Synthron/Plantomation/README.md

# Plantomation
Automatic Plant Watering System with ESP32

## V1
Capable of handling 4 channels simultaneously with one pump

## V2
Capable of handling 12 channels simultaneously with two pumps

---
**WORK IN PROGRESS**
