Synthron/Plantomation/V1/doc/titel/titel.tex

\begin{titlepage}

\vspace*{2cm}
\noindent
\titlefont \Titel\par
\epigraph{\Caption}
{\SignateAuthor}
\vspace*{2cm}
\centering{}
\null\vfill
\vspace*{1cm}
\noindent
\hfill
\begin{minipage}{0.4\linewidth}
    \begin{flushright}
        \printauthor
    \end{flushright}
\end{minipage}
%
\begin{minipage}{0.02\linewidth}
    \rule{1pt}{80pt}
\end{minipage}
\titlepagedecoration
\chapterdecoration
\end{titlepage}
