Synthron/Plantomation/V1/doc/tech-note.tex

\documentclass[11pt, a4paper, listof=numbered, captions=tableheading, headinclude, table, xcdraw]{scrreprt}
\usepackage[utf8]{inputenc}
\usepackage{babel}
\usepackage{tikz}
\usepackage{epigraph}
\usepackage{xcolor}
\usepackage{amsmath}
\usepackage{textgreek}
\usepackage[LGRgreek]{mathastext}
\usepackage{array}
\usepackage{color}
\usepackage{graphicx}
\usepackage{float}
\usepackage{helvet}
\usepackage{scrhack}
\usepackage{makecell}
\usepackage{dirtree}
\usepackage{multirow}
\usepackage{listings}
\lstset{language=C,keywordstyle={\bfseries \color{blue}}}
\NewDocumentCommand{\codeword}{v}{%
\texttt{\textcolor{blue}{#1}}%
}
\renewcommand{\familydefault}{\sfdefault}

\RedeclareSectionCommands[toclinefill=\TOCLineLeaderFill]{part,chapter}

\setlength{\emergencystretch}{\hsize}
\tolerance=9999

\usepackage[hidelinks, hypertexnames=false]{hyperref}

\renewcommand\epigraphflush{flushright}
\renewcommand\epigraphsize{\normalsize}
\setlength\epigraphwidth{0.7\textwidth}

\definecolor{titlepagecolor1}{cmyk}{.82,.24,0,.11}
\definecolor{titlepagecolor}{cmyk}{0,.33,.98,.2}

\DeclareFixedFont{\titlefont}{T1}{ppl}{b}{it}{0.5in}

\setlength{\parindent}{0pt}

\usepackage[top=1.5cm,bottom=1cm,right=2cm,left=2cm,includeheadfoot]{geometry}

\newcommand{\Titel}{Documentation\\\vspace{.5mm}Plantomation V1.0}
\newcommand{\Caption}{Automatic Plant Watering System}
\newcommand{\SignateAuthor}{\textit{Made with \LaTeX}}
\newcommand{\Stand}{\textit{Compiled: \today}}

\usepackage[automark]{scrlayer-scrpage}

\input{titel/titel-meta.tex}
\begin{document}
\input{titel/titel.tex}

\KOMAoptions{parskip=half}

\setcounter{tocdepth}{2}
\cohead[I Table Of Contents]{I Table Of Contents}
\pagestyle{scrheadings}
\tableofcontents 	\newpage

\lohead[\today]{\today}
\cohead[Plantomation]{Plantomation}
\rohead[Synthron]{Synthron}
\pagestyle{scrheadings}

\DTsetlength{0.2em}{2em}{0.2em}{0.4pt}{1.6pt}

\input{chapters/00-intro.tex}  	
\input{chapters/01-filesystem.tex}  	
\input{chapters/02-config.tex}
\input{chapters/10-gettingstarted.tex}
\input{chapters/20-troubleshoot.tex}
\input{chapters/30-operation.tex}

\end{document}
