Synthron/Plantomation/V2/3D_files/Valve_Bar.3mf

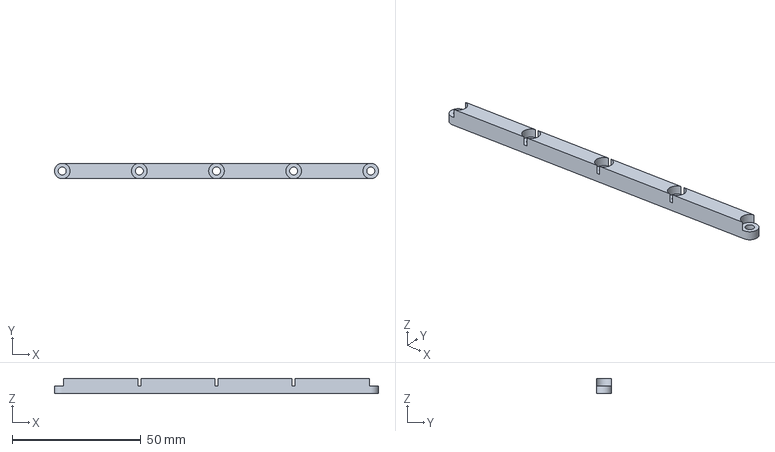
[picture p3: CAD file, 2024-04-07]
V2/3D_files/Valve_Bar.3mf
126.0 x 6.00 x 6.00 mm
