Synthron/Plantomation/V2/Hardware/3d_models/IHLP4040DZ (2.2-100uH).STEP

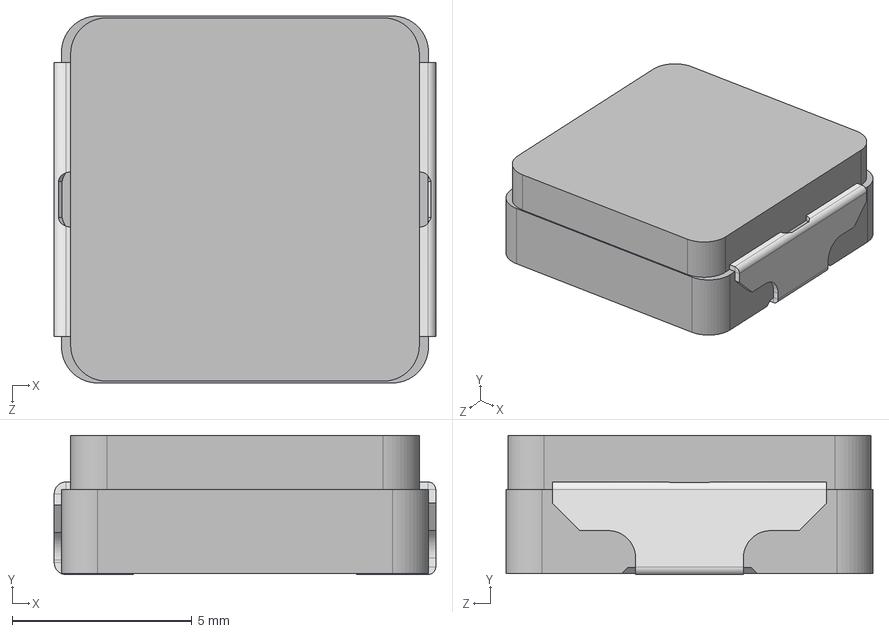
[picture p4: CAD file, 2024-03-05]
V2/Hardware/3d_models/IHLP4040DZ (2.2-100uH).STEP
10.6 x 3.87 x 10.2 mm
