Synthron/Plantomation/V2/3D_files/base.3mf

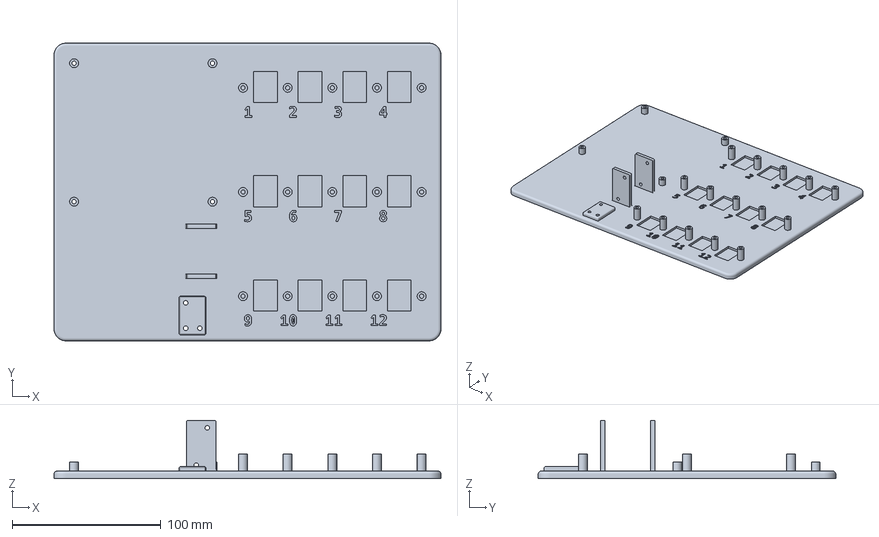
[picture p5: CAD file, 2024-04-07]
V2/3D_files/base.3mf
260.0 x 200.0 x 39.0 mm
