Synthron/Plantomation/V2/Hardware/3d_models/DM3AT-SF-PEJM5--3DModel-STEP-1.STEP

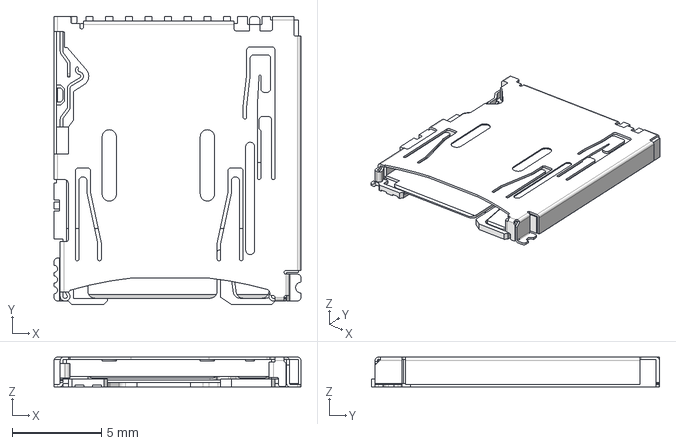
[picture p6: CAD file, 2024-03-05]
V2/Hardware/3d_models/DM3AT-SF-PEJM5--3DModel-STEP-1.STEP
13.8 x 16.2 x 1.68 mm
