Synthron/Plantomation/V2/3D_files/base_v2.FCStd

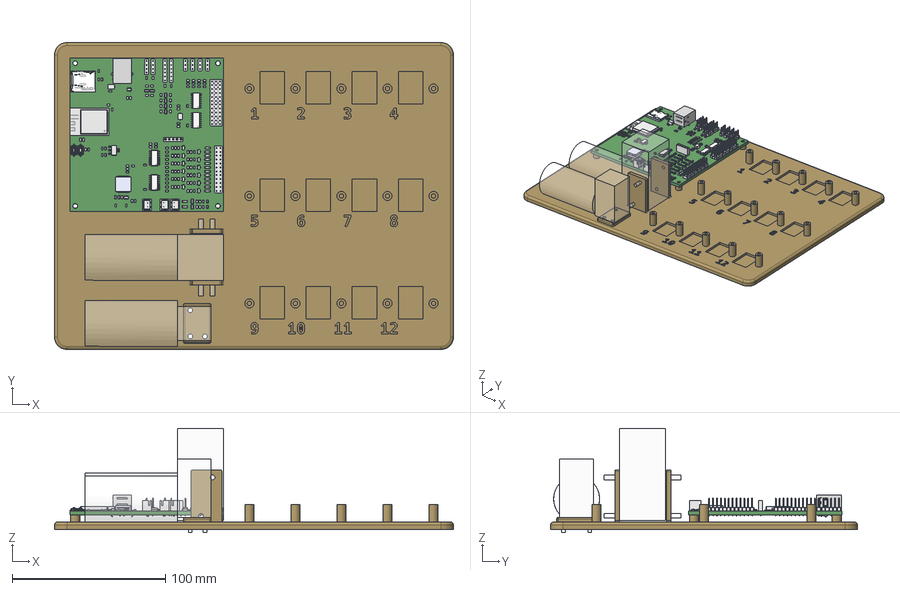
[picture p7: CAD file, 2024-04-07]
V2/3D_files/base_v2.FCStd
260.0 x 200.0 x 68.0 mm
Pcb_db99
Q203_SOT_23_44570731e5b5 x 20
R204_R_0805_2012Metric_d202d1052620 x 75
C110_C_0805_2012Metric_43a1fb40b60a x 32
D211_D_MiniMELF_Standard_09ee5b82a0d6 x 14
D218_LED_0805_2012Metric_5a11dceac025 x 16
SMB-001 x 2
SMB-002 x 2
SMB-003 x 2
J403_PinHeader_1x04_P254mm_Vertical_74da8d033dea x 2
J401_DM3AT-SF-PEJM5_e288499444ba
U102_ESP32-WROOM-32_25d6985203dc
J307_PinHeader_1x03_P254mm_Vertical_c9eca30b1be4 x 4
J406_PinHeader_1x06_P254mm_Vertical_8fe038bee00d x 2
J201_PinHeader_2x12_P254mm_Vertical_0cf915f84885
J301_PinHeader_1x12_P254mm_Vertical_490f5f7cb445 x 3
L101_IHLP4040DZ (2.2-100uH)_65aa9d9f0eec
J204_PinSocket_1x05_P254mm_Vertical_2877e723dfbb
U301_SOIC-16_4.55x10.3mm_P1.27mm_85294fd43e5c x 4
J202_JST_B2B_XH_A_84ebe7f06565 x 3
U105_SOT_223_6202c68c321c
USB-B-S-TH_P
USB-B-S-B-TH_B
USB-B-S-TH_S
U101_SOT_23_6_170c0ff91525 x 2
PTS636Sx25SMTRLFS x 2
PTS636Sx25SMTRLFS001 x 2
PTS636Sx25SMTRLFS002 x 2
PTS636Sx25SMTRLFS003 x 2
PTS636Sx25SMTRLFS004 x 2
NF60
NF25
