Synthron/Plantomation/V2/Hardware/3d_models/USB-B-S-F-B-TH.stp

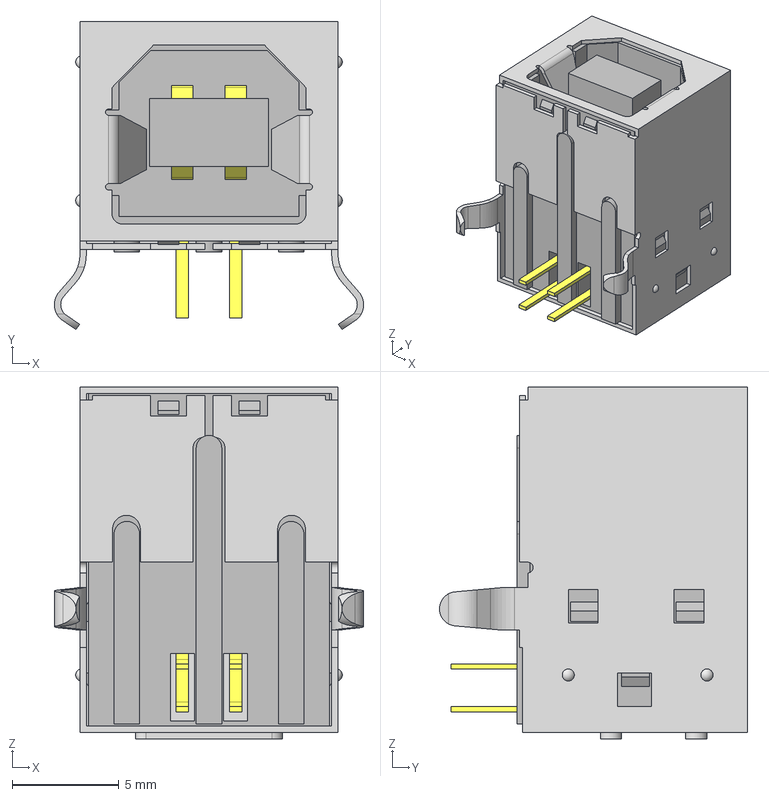
[picture p8: CAD file, 2023-11-27]
V2/Hardware/3d_models/USB-B-S-F-B-TH.stp
14.5 x 14.4 x 16.5 mm
USB-B-S-TH_P
USB-B-S-B-TH_B
USB-B-S-TH_S
