Synthron/Plantomation/V2/3D_files/baseplate-fixbar.3mf

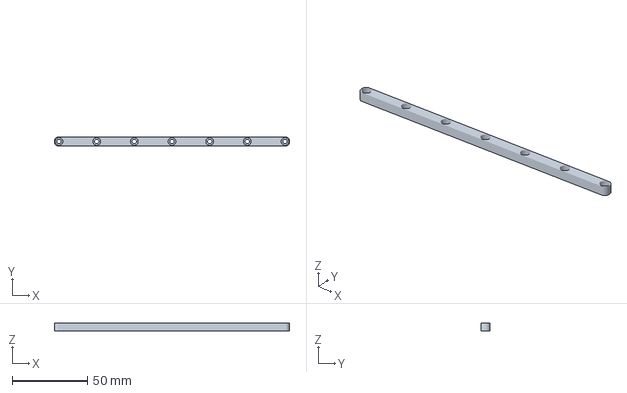
[picture p9: CAD file, 2024-03-17]
V2/3D_files/baseplate-fixbar.3mf
156.0 x 6.00 x 5.00 mm
