Synthron/Plantomation/V2/3D_files/baseplate.FCStd

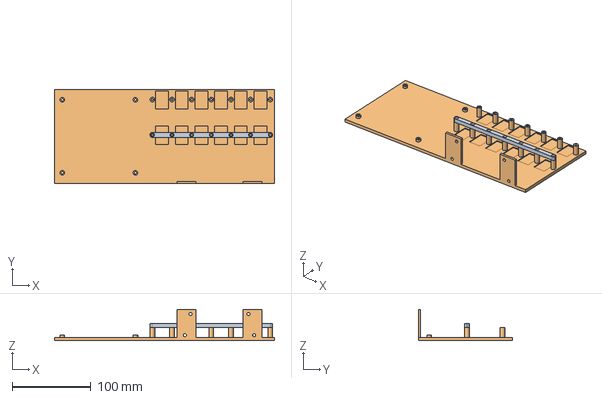
[picture p10: CAD file, 2024-03-17]
V2/3D_files/baseplate.FCStd
280.0 x 120.0 x 40.0 mm
