Synthron/Plantomation/V1/3D Files/base.3mf

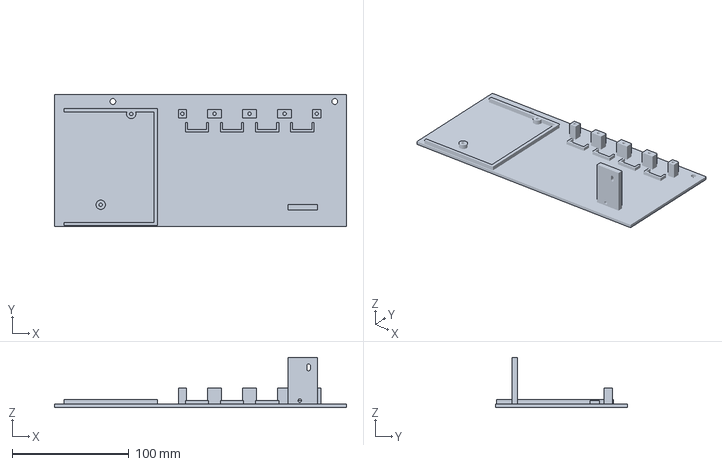
[picture p11: CAD file, 2023-12-03, an earlier design]
V1/3D Files/base.3mf
250.0 x 113.0 x 43.0 mm
