Synthron/Plantomation/V1/carrier_plate.FCStd

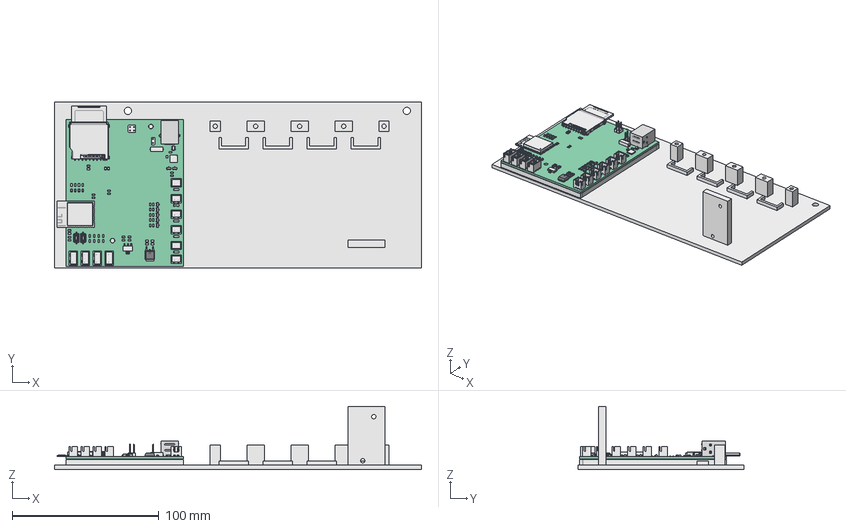
[picture p12: CAD file, 2023-12-03, an earlier design]
V1/carrier_plate.FCStd
250.0 x 113.0 x 43.0 mm
Pcb_6730
R19_R_0805_2012Metric_4a6928e6c3b8 x 27
Q7_SOT_23_91e60cba1a9a x 7
C2_C_0805_2012Metric_00742ca926a0 x 19
U1_ESP32-WROOM-32_6e9d93ef4292
PTS636Sx25SMTRLFS x 2
PTS636Sx25SMTRLFS001 x 2
PTS636Sx25SMTRLFS002 x 2
PTS636Sx25SMTRLFS003 x 2
PTS636Sx25SMTRLFS004 x 2
D4_LED_0805_2012Metric_402ffccf9469 x 4
932d09b3-9c39-11ed-93f0-dde97e994e83_part
932d09b4-9c39-11ed-93f0-dde97e994e83_part
932d09b5-9c39-11ed-93f0-dde97e994e83_part
932d09b5-9c39-11ed-93f0-dde97e994e83_part001
932d09b5-9c39-11ed-93f0-dde97e994e83_part002
D6_D_MiniMELF_Standard_5b1763afe809 x 5
J6_JST_B3B_XH_A_3265b5583f52 x 4
U4_SOT_223_8c25a17023d9
J9_JST_B2B_XH_A_89ff38e0742e x 6
SD Card
SD Card001
U5_QFN-28-1EP_5x5mm_Pitch0.5mm_6fd3eef4e2dd
U2_SOT_23_6_705da7459335
SMB-002
SMB-003
SMB-004
J13_PinHeader_2x02_P254mm_Vertical_e2c9f7a34c26
JP1_PinHeader_1x02_P254mm_Vertical_8e198357df73
USB-B-S-TH_P
USB-B-S-B-TH_B
USB-B-S-TH_S
