Synthron/Plantomation/V1/Hardware/3d_models/fk_244_13_d_pak.stp

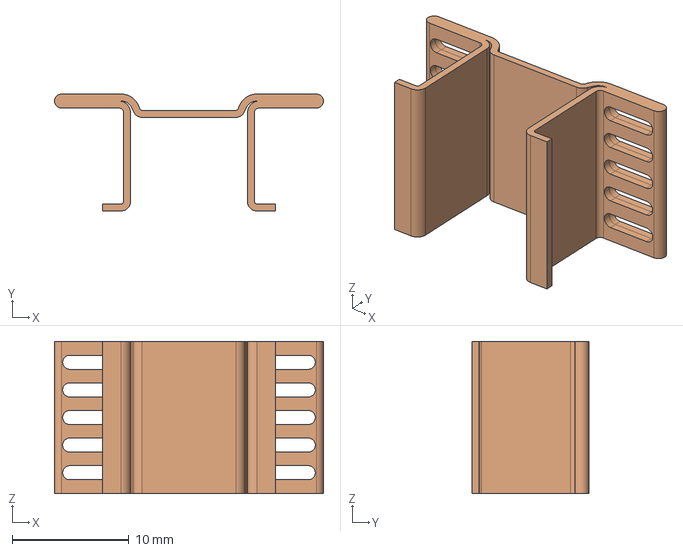
[picture p13: CAD file, 2023-11-27, an earlier design]
V1/Hardware/3d_models/fk_244_13_d_pak.stp
23.0 x 10.0 x 13.0 mm
