Synthron/Plantomation/V1/3D Files/fixer.3mf

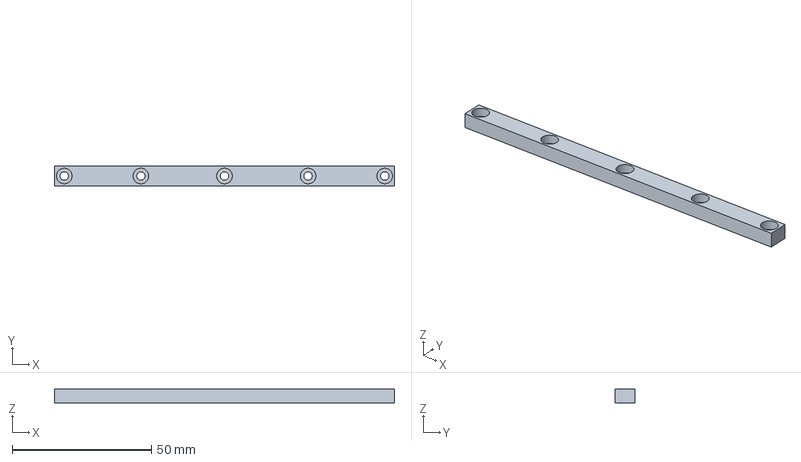
[picture p14: CAD file, 2023-11-30, an earlier design]
V1/3D Files/fixer.3mf
122.0 x 7.00 x 5.00 mm
