Synthron/Plantomation/V1/3D Files/hose_fix.3mf

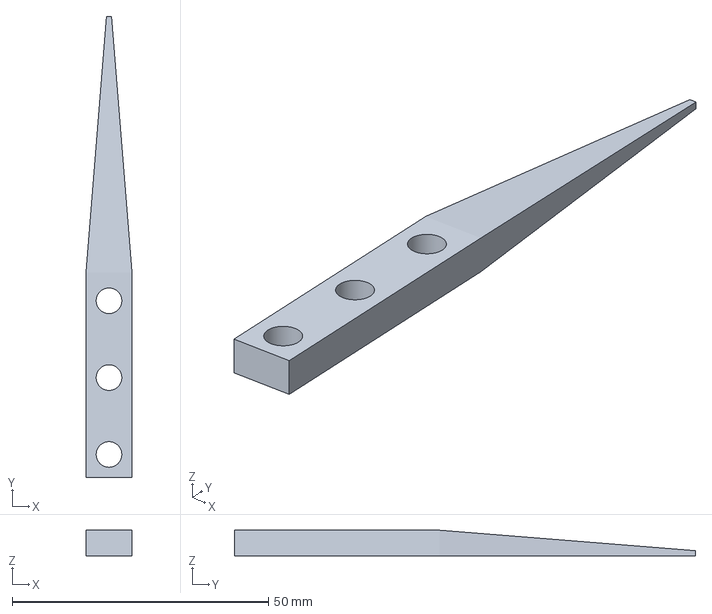
[picture p15: CAD file, 2023-11-30, an earlier design]
V1/3D Files/hose_fix.3mf
9.00 x 90.0 x 5.00 mm
