Synthron/Plantomation/V1/Hardware/3d_models/SD Card.STEP

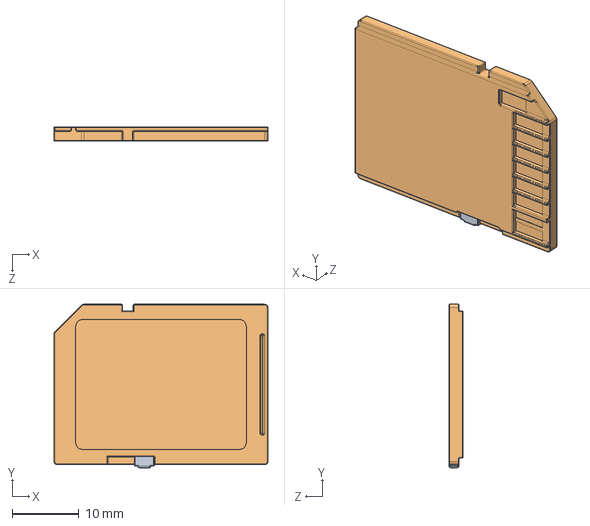
[picture p16: CAD file, 2023-11-26, an earlier design]
V1/Hardware/3d_models/SD Card.STEP
32.0 x 24.4 x 2.15 mm
