Synthron/Plantomation/V1/Hardware/3d_models/GSD090012SEU.stp

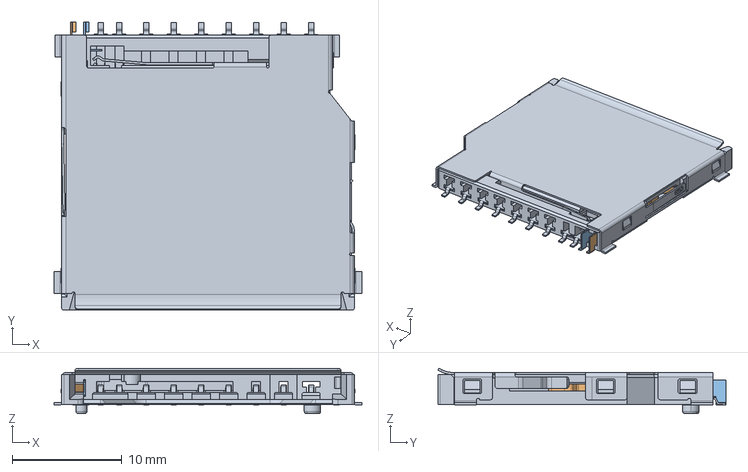
[picture p17: CAD file, 2023-11-27, an earlier design]
V1/Hardware/3d_models/GSD090012SEU.stp
28.0 x 26.2 x 4.13 mm
