Synthron/Plantomation/(list of files, cad)

Other CAD files:
V1/3D Files/carrier_plate.FCStd
V2/3D_files/baseplate.3mf
