Synthron/Plantomation/V1/Hardware/Plantomation.pdf

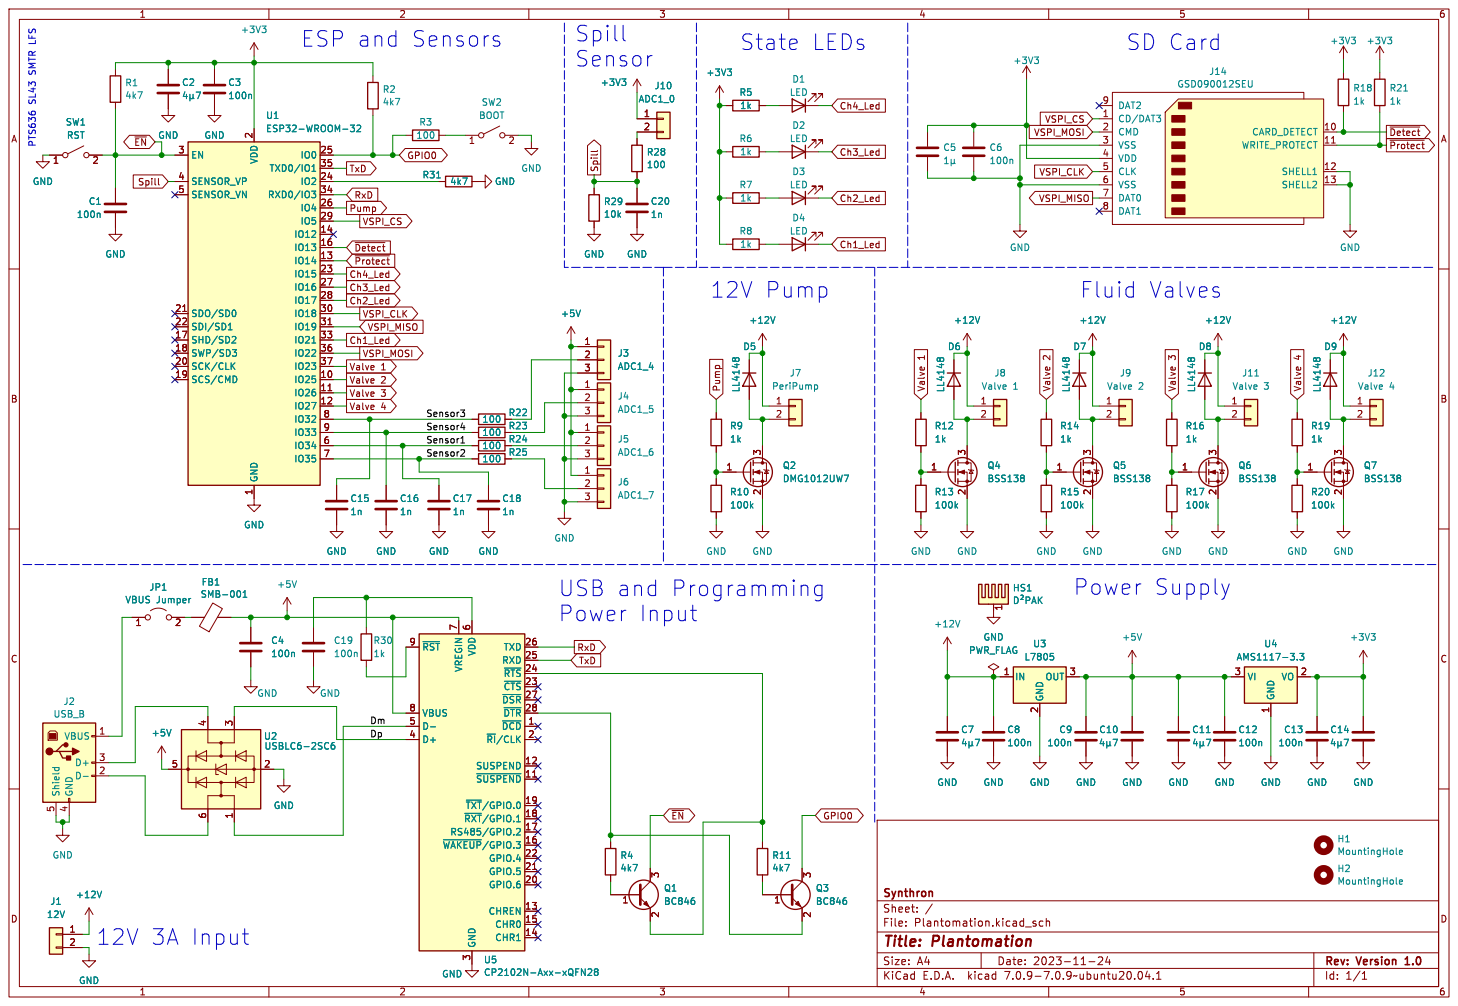
[picture p18: page 1]

Power Supply PTS636 SL43 SMTR LFS

2 SCK/CLK 20 SDO/SD0 21 SDI/SD1 22
