Synthron/Plantomation/V2/Hardware/Plantomation_V2.kicad_pcb

## KiCad design V2/Hardware/Plantomation_V2.kicad_pcb (2024-03-17)

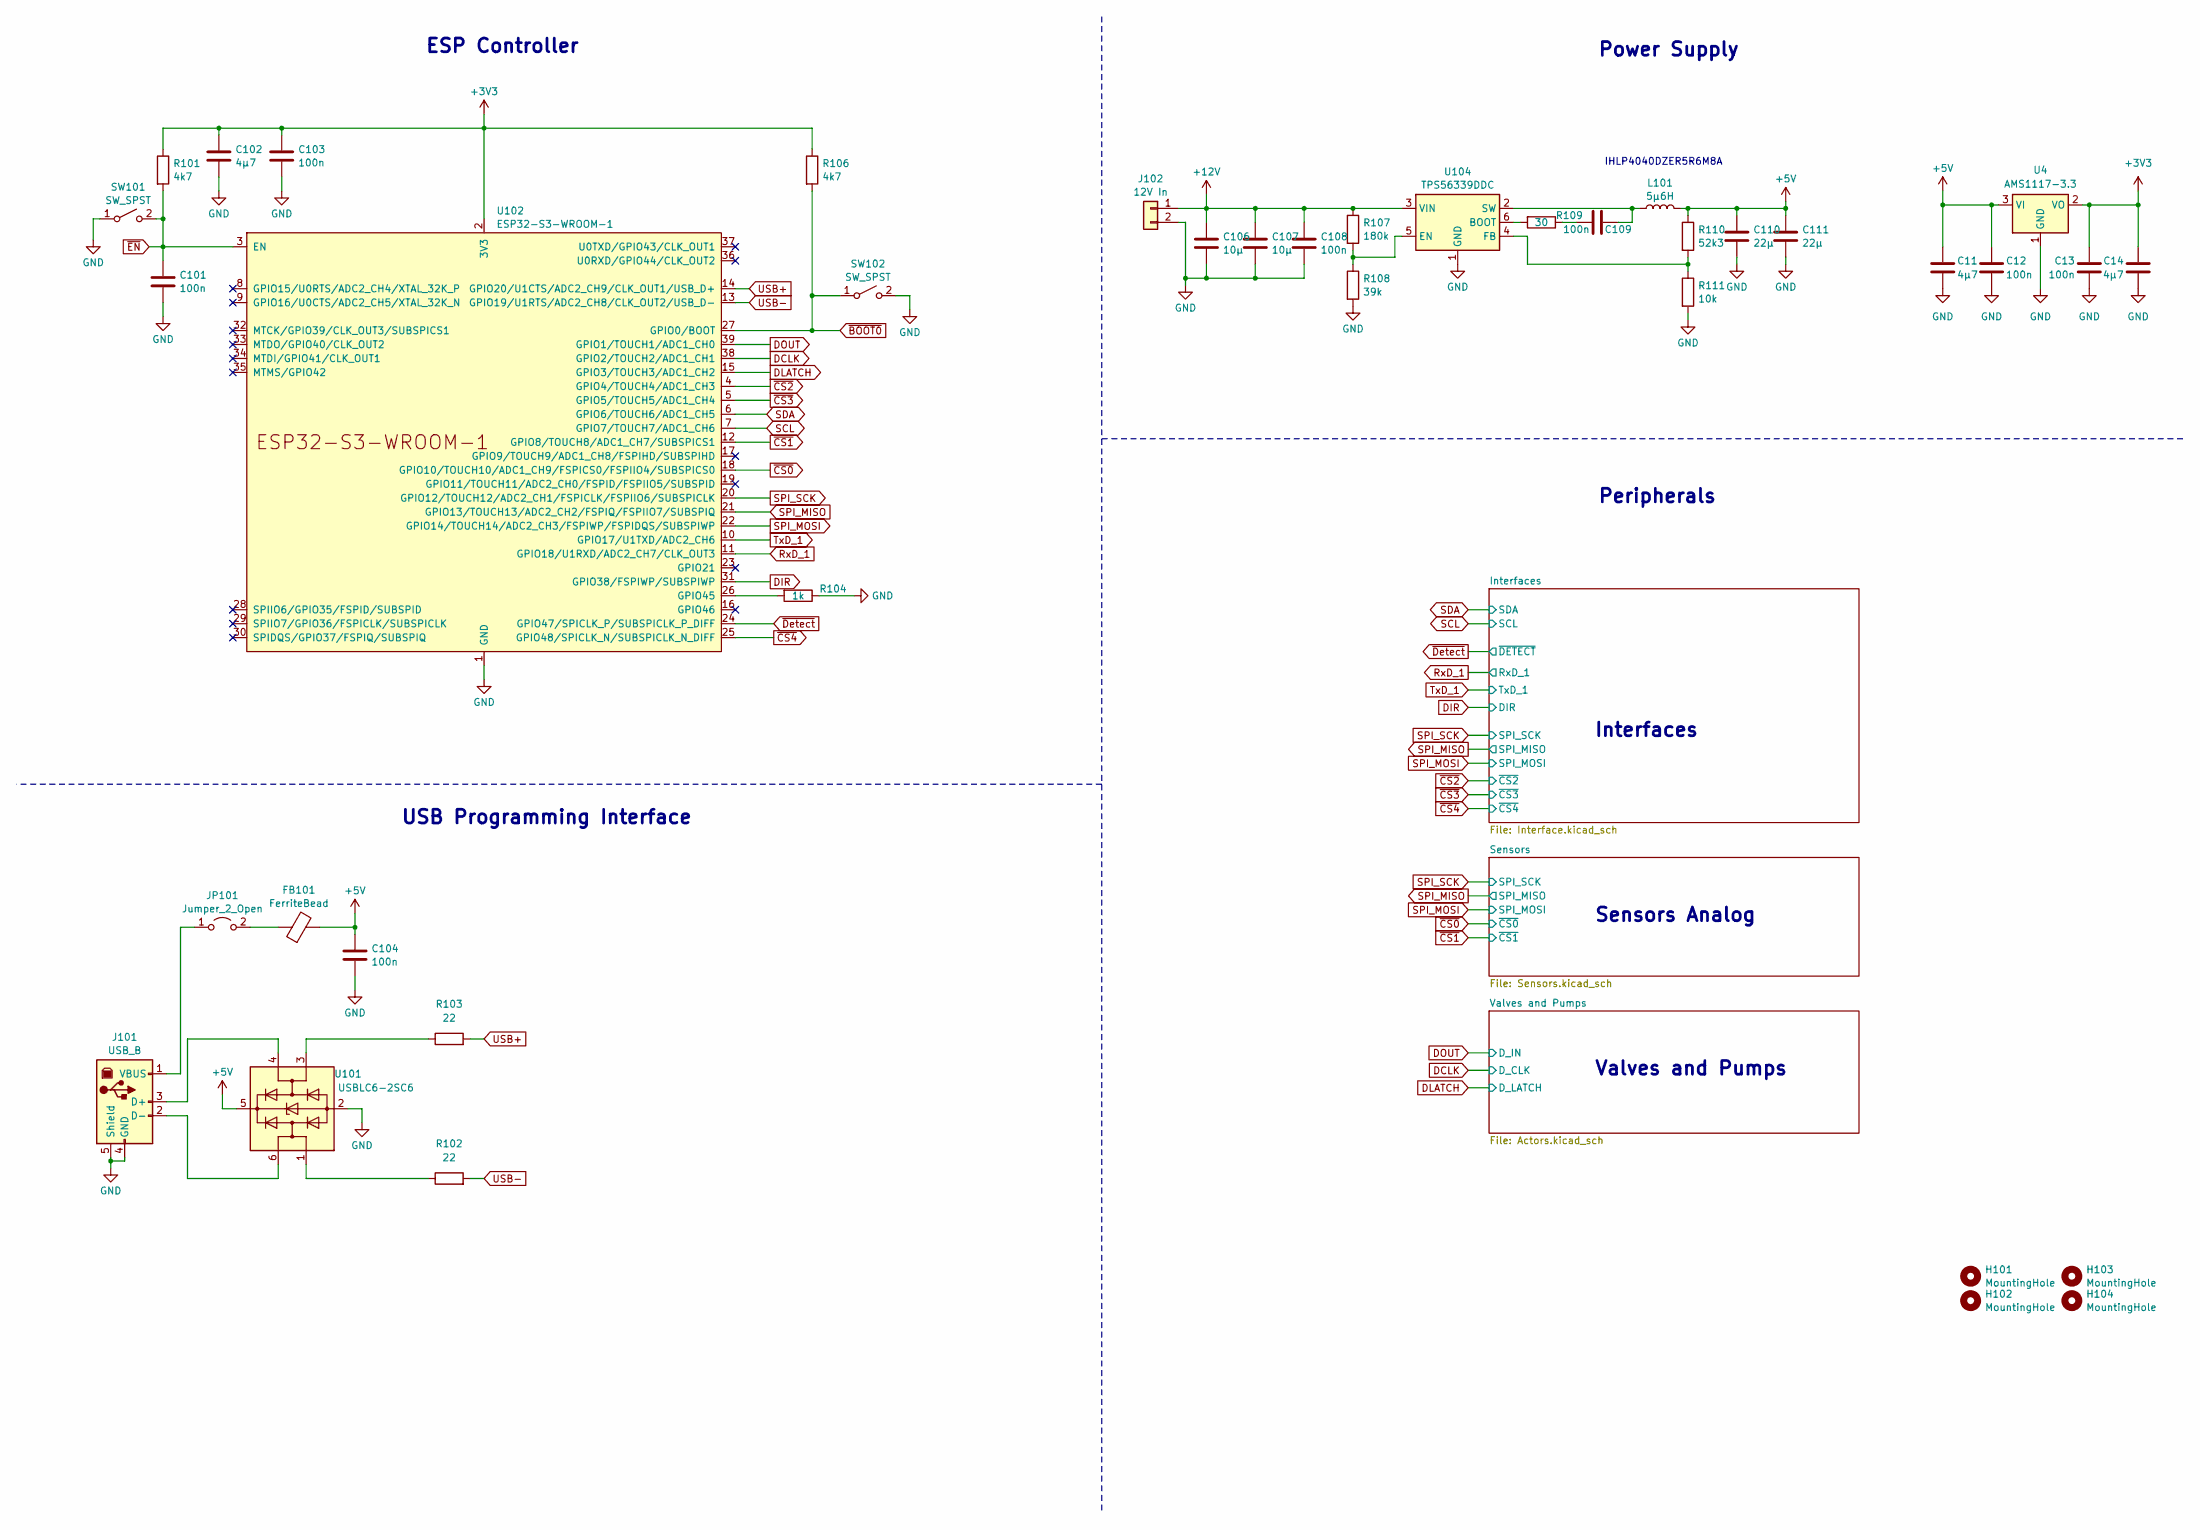
[picture p19: schematic Plantomation_V2.kicad_sch, Plantomation V2]

Parts:
C11, C14, C102: 4µ7; C_0805_2012Metric
C12, C13, C101, C103, C104, C108, C109: 100n; C_0805_2012Metric
C106, C107: 10µ; C_0805_2012Metric
C110, C111: 22µ; C_0805_2012Metric
FB101: FerriteBead; SMB-001
H101, H102, H103, H104: MountingHole; MountingHole_3.2mm_M3
J101: USB_B; USB_B_Lumberg_2411_02_Horizontal
J102: 12V In; JST_XH_B2B-XH-A_1x02_P2.50mm_Vertical
JP101: Jumper_2_Open; SolderJumper-2_P1.3mm_Open_TrianglePad1.0x1.5mm
L101: 5µ6H; L_Vishay_IHLP-4040
R101, R106: 4k7; R_0805_2012Metric
R102, R103: 22; R_0805_2012Metric
R104: 1k; R_0805_2012Metric
R107: 180k; R_0805_2012Metric
R108: 39k; R_0805_2012Metric
R109: 30; R_0805_2012Metric
R110: 52k3; R_0805_2012Metric
R111: 10k; R_0805_2012Metric
SW101, SW102: SW_SPST; SW_Tactile_SPST_NO_Straight_CK_PTS636Sx25SMTRLFS
U4: AMS1117-3.3; SOT-223-3_TabPin2
U101: USBLC6-2SC6; SOT-23-6
U102: ESP32-S3-WROOM-1
U104: TPS56339DDC; SOT-23-6

Connections:
+3V3: C102.1, C103.1, R101.1, R106.1, U102.2 (3V3); also elsewhere on the board
+5V: C104.1, C110.1, C111.1, FB101.2, L101.2, R110.1, U101.5 (VBUS); also elsewhere on the board
+12V: C106.1, C107.1, C108.1, J102.1, R107.1, U104.3 (VIN); also elsewhere on the board
DCLK: U102.38 (GPIO2/TOUCH2/ADC1_CH1); also elsewhere on the board
DIR: U102.31 (GPIO38/FSPIWP/SUBSPIWP)
DLATCH: U102.15 (GPIO3/TOUCH3/ADC1_CH2); also elsewhere on the board
DOUT: U102.39 (GPIO1/TOUCH1/ADC1_CH0); also elsewhere on the board
GND: C101.2, C102.2, C103.2, C104.2, C106.2, C107.2, C108.2, C110.2, C111.2, J101.4 (GND), J101.5 (Shield), J102.2, R104.1, R108.2, R111.2, SW101.1 (A), SW102.2 (B), U101.2 (GND), U102.1 (GND), U102.40 (GND), U102.41 (GND), U104.1 (GND); also elsewhere on the board
unnamed: C109.1, R109.1
unnamed: J101.3 (D+), U101.4 (I/O2)
unnamed: J101.2 (D-), U101.6 (I/O1)
unnamed: J101.1 (VBUS), JP101.1 (A)
unnamed: FB101.1, JP101.2 (B)
unnamed: R102.1, U101.1 (I/O1)
unnamed: R103.1, U101.3 (I/O2)
unnamed: R104.2, U102.26 (GPIO45)
unnamed: R109.2, U104.6 (BOOT)
unnamed: R107.2, R108.1, U104.5 (EN)
unnamed: R110.2, R111.1, U104.4 (FB)
unnamed: C109.2, L101.1, U104.2 (SW)
RxD_1: U102.11 (GPIO18/U1RXD/ADC2_CH7/CLK_OUT3)
SCL: U102.7 (GPIO7/TOUCH7/ADC1_CH6); also elsewhere on the board
SDA: U102.6 (GPIO6/TOUCH6/ADC1_CH5); also elsewhere on the board
SPI_MISO: U102.21 (GPIO13/TOUCH13/ADC2_CH2/FSPIQ/FSPIIO7/S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); also elsewhere on the board
SPI_MOSI: U102.22 (GPIO14/TOUCH14/ADC2_CH3/FSPIWP/FSPIDQS/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); also elsewhere on the board
SPI_SCK: U102.20 (GPIO12/TOUCH12/ADC2_CH1/FSPICLK/FSPIIO6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); also elsewhere on the board
TxD_1: U102.10 (GPIO17/U1TXD/ADC2_CH6)
USB+: R103.2, U102.14 (GPIO20/U1CTS/ADC2_CH9/CLK_OUT1/USB_D+)
USB-: R102.2, U102.13 (GPIO19/U1RTS/ADC2_CH8/CLK_OUT2/USB_D-)
~BOOT0: R106.2, SW102.1 (A), U102.27 (GPIO0/BOOT)
~CS0: U102.18 (GPIO10/TOUCH10/ADC1_CH9/FSPICS0/FSPIIO4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); also elsewhere on the board
~CS1: U102.12 (GPIO8/TOUCH8/ADC1_CH7/SUBSPICS1); also elsewhere on the board
~CS2: U102.4 (GPIO4/TOUCH4/ADC1_CH3); also elsewhere on the board
~CS3: U102.5 (GPIO5/TOUCH5/ADC1_CH4); also elsewhere on the board
~CS4: U102.25 (GPIO48/SPICLK_N/SUBSPICLK_N_DIFF); also elsewhere on the board
~Detect: U102.24 (GPIO47/SPICLK_P/SUBSPICLK_P_DIFF); also elsewhere on the board
~EN: C101.1, R101.2, SW101.2 (B), U102.3 (EN)

Notes on the sheet:
Valves and Pumps
IHLP4040DZER5R6M8A
Interfaces
Sensors Analog
Peripherals
Power Supply
ESP Controller
USB Programming Interface

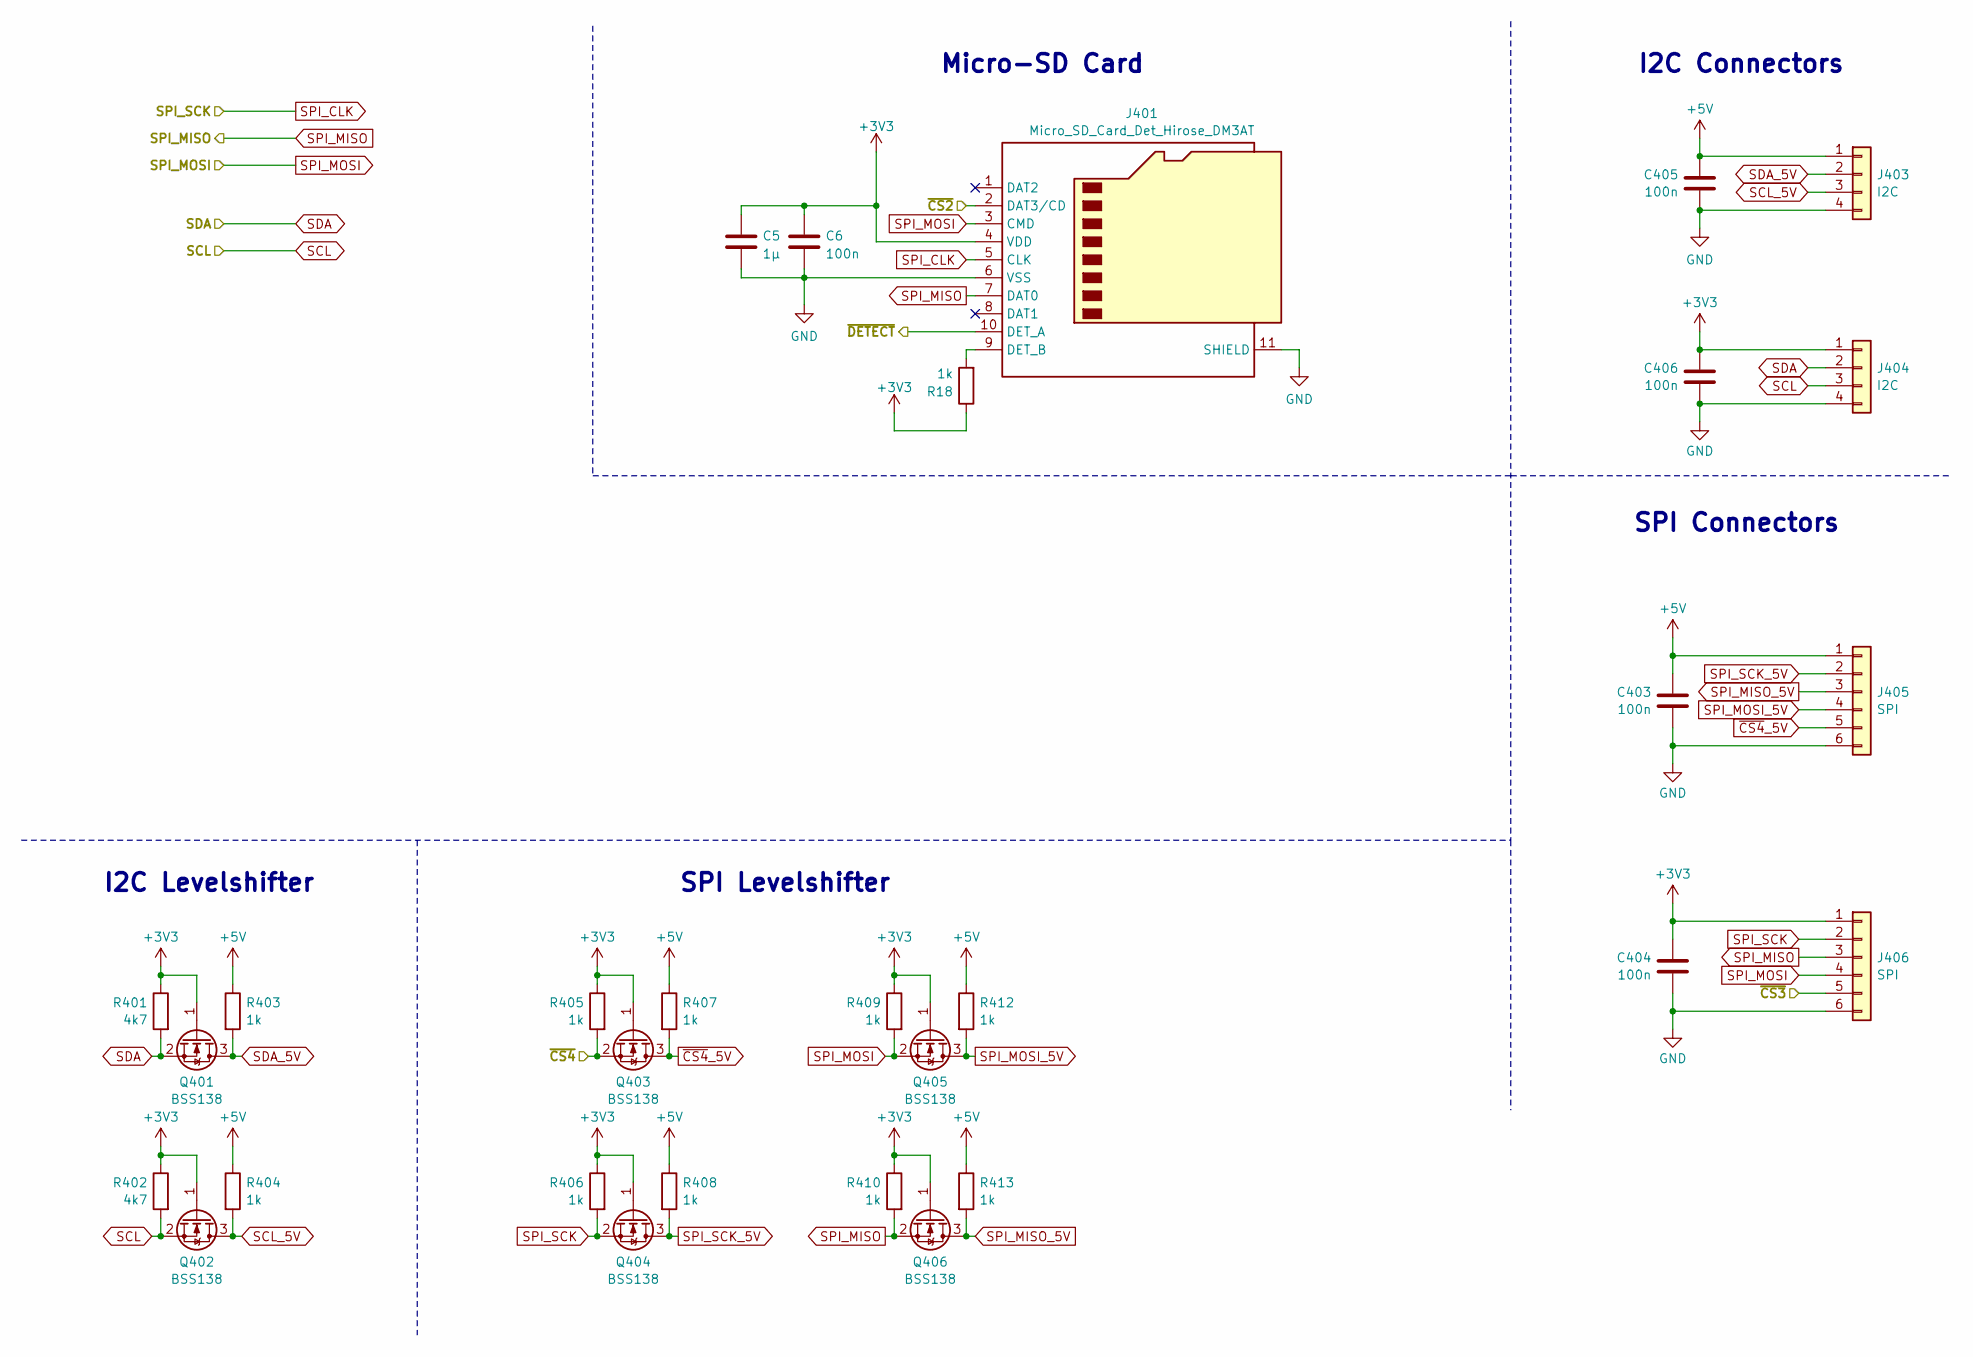
[picture p20: schematic Interface.kicad_sch]

Parts:
C5: 1µ; C_0805_2012Metric
C6, C403, C404, C405, C406: 100n; C_0805_2012Metric
J401: Micro_SD_Card_Det_Hirose_DM3AT; microSD_HC_Hirose_DM3AT-SF-PEJM5
J403, J404: I2C; PinHeader_1x04_P2.54mm_Vertical
J405, J406: SPI; PinHeader_1x06_P2.54mm_Vertical
Q401, Q402, Q403, Q404, Q405, Q406: BSS138; SOT-23
R18, R403, R404, R405, R406, R407, R408, R409, R410, R412, R413: 1k; R_0805_2012Metric
R401, R402: 4k7; R_0805_2012Metric

Connections:
+3V3: C404.1, C406.1, J401.4 (VDD), J404.1, J406.1, Q401.1 (G), Q402.1 (G), Q403.1 (G), Q404.1 (G), Q405.1 (G), Q406.1 (G), R401.1, R402.1, R405.1, R406.1, R409.1, R410.1; also elsewhere on the board
+5V: C403.1, C405.1, J403.1, J405.1, R403.1, R404.1, R407.1, R408.1, R412.1, R413.1; also elsewhere on the board
GND: C403.2, C404.2, C405.2, C406.2, J401.6 (VSS), J401.11 (SHIELD), J403.4, J404.4, J405.6, J406.6; also elsewhere on the board
unnamed 51: J401.9 (DET_B); also elsewhere on the board
SCL: J404.3, Q402.2 (S), R402.2; also elsewhere on the board
SCL_5V: J403.3, Q402.3 (D), R404.2
SDA: J404.2, Q401.2 (S), R401.2; also elsewhere on the board
SDA_5V: J403.2, Q401.3 (D), R403.2
SPI_MISO: J401.7 (DAT0), J406.3, Q406.2 (S), R410.2; also elsewhere on the board
SPI_MISO_5V: J405.3, Q406.3 (D), R413.2
SPI_MOSI: J401.3 (CMD), J406.4, Q405.2 (S), R409.2; also elsewhere on the board
SPI_MOSI_5V: J405.4, Q405.3 (D), R412.2
SPI_SCK: J401.5 (CLK), J406.2, Q404.2 (S), R406.2; also elsewhere on the board
SPI_SCK_5V: J405.2, Q404.3 (D), R408.2
~CS2: J401.2 (DAT3/CD); also elsewhere on the board
~CS3: J406.5; also elsewhere on the board
~CS4: Q403.2 (S), R405.2; also elsewhere on the board
~CS4_5V: J405.5, Q403.3 (D), R407.2
~Detect: J401.10 (DET_A); also elsewhere on the board

Notes on the sheet:
I2C Connectors
SPI Levelshifter
Micro-SD Card
SPI Connectors
I2C Levelshifter

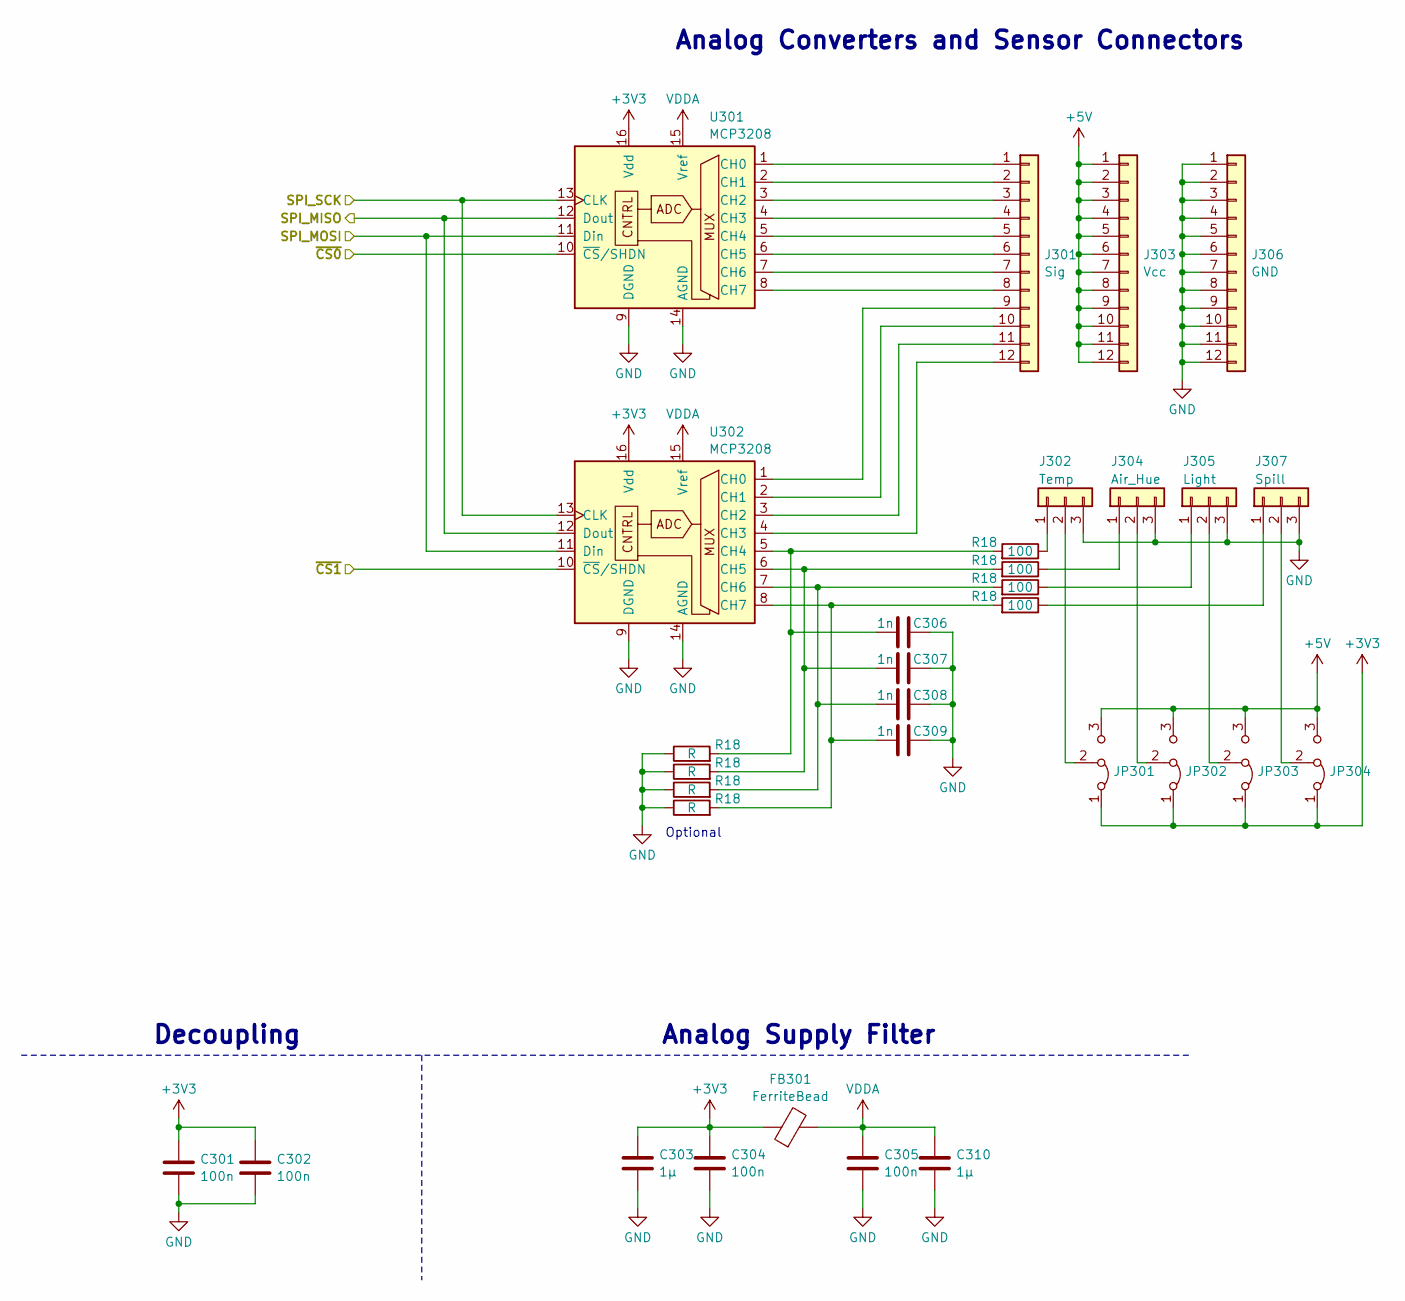
[picture p21: schematic Sensors.kicad_sch]

Parts:
C301, C302, C304, C305: 100n; C_0805_2012Metric
C303, C310: 1µ; C_0805_2012Metric
C306, C307, C308, C309: 1n; C_0805_2012Metric
FB301: FerriteBead; SMB-001
J301: Sig; PinHeader_1x12_P2.54mm_Vertical
J302: Temp; PinHeader_1x03_P2.54mm_Vertical
J303: Vcc; PinHeader_1x12_P2.54mm_Vertical
J304: Air_Hue; PinHeader_1x03_P2.54mm_Vertical
J305: Light; PinHeader_1x03_P2.54mm_Vertical
J306: GND; PinHeader_1x12_P2.54mm_Vertical
J307: Spill; PinHeader_1x03_P2.54mm_Vertical
JP301, JP302, JP303, JP304: Jumper_3_Bridged12; SolderJumper-3_P1.3mm_Open_Pad1.0x1.5mm
R18: R; R_0805_2012Metric
U301, U302: MCP3208; SOIC-16_4.55x10.3mm_P1.27mm

Connections:
+3V3: C301.1, C302.1, C303.1, C304.1, FB301.1, JP301.1 (A), JP302.1 (A), JP303.1 (A), JP304.1 (A), U301.16 (Vdd), U302.16 (Vdd); also elsewhere on the board
+5V: J303.1, J303.2, J303.3, J303.4, J303.5, J303.6, J303.7, J303.8, J303.9, J303.10, J303.11, J303.12, JP301.3 (B), JP302.3 (B), JP303.3 (B), JP304.3 (B); also elsewhere on the board
GND: C301.2, C302.2, C303.2, C304.2, C305.2, C306.2, C307.2, C308.2, C309.2, C310.2, J302.3, J304.3, J305.3, J306.1, J306.2, J306.3, J306.4, J306.5, J306.6, J306.7, J306.8, J306.9, J306.10, J306.11, J306.12, J307.3, U301.9 (DGND), U301.14 (AGND), U302.9 (DGND), U302.14 (AGND); also elsewhere on the board
unnamed: J301.1, U301.1 (CH0)
unnamed: J301.2, U301.2 (CH1)
unnamed: J301.3, U301.3 (CH2)
unnamed: J301.4, U301.4 (CH3)
unnamed: J301.5, U301.5 (CH4)
unnamed: J301.6, U301.6 (CH5)
unnamed: J301.7, U301.7 (CH6)
unnamed: J301.8, U301.8 (CH7)
unnamed: J301.9, U302.1 (CH0)
unnamed: J301.10, U302.2 (CH1)
unnamed: J301.11, U302.3 (CH2)
unnamed: J301.12, U302.4 (CH3)
unnamed 43: J302.1; also elsewhere on the board
unnamed: J302.2, JP301.2 (C)
unnamed 45: J304.1; also elsewhere on the board
unnamed: J304.2, JP302.2 (C)
unnamed 47: J305.1; also elsewhere on the board
unnamed: J305.2, JP303.2 (C)
unnamed 49: J307.1; also elsewhere on the board
unnamed: J307.2, JP304.2 (C)
unnamed 75: C306.1, U302.5 (CH4); also elsewhere on the board
unnamed 76: C307.1, U302.6 (CH5); also elsewhere on the board
unnamed 77: C308.1, U302.7 (CH6); also elsewhere on the board
unnamed 78: C309.1, U302.8 (CH7); also elsewhere on the board
SPI_MISO: U301.12 (Dout), U302.12 (Dout); also elsewhere on the board
SPI_MOSI: U301.11 (Din), U302.11 (Din); also elsewhere on the board
SPI_SCK: U301.13 (CLK), U302.13 (CLK); also elsewhere on the board
VDDA: C305.1, C310.1, FB301.2, U301.15 (Vref), U302.15 (Vref)
~CS0: U301.10 (~CS/SHDN); also elsewhere on the board
~CS1: U302.10 (~CS/SHDN); also elsewhere on the board

Notes on the sheet:
Analog Converters and Sensor Connectors
Analog Supply Filter
Decoupling
Optional

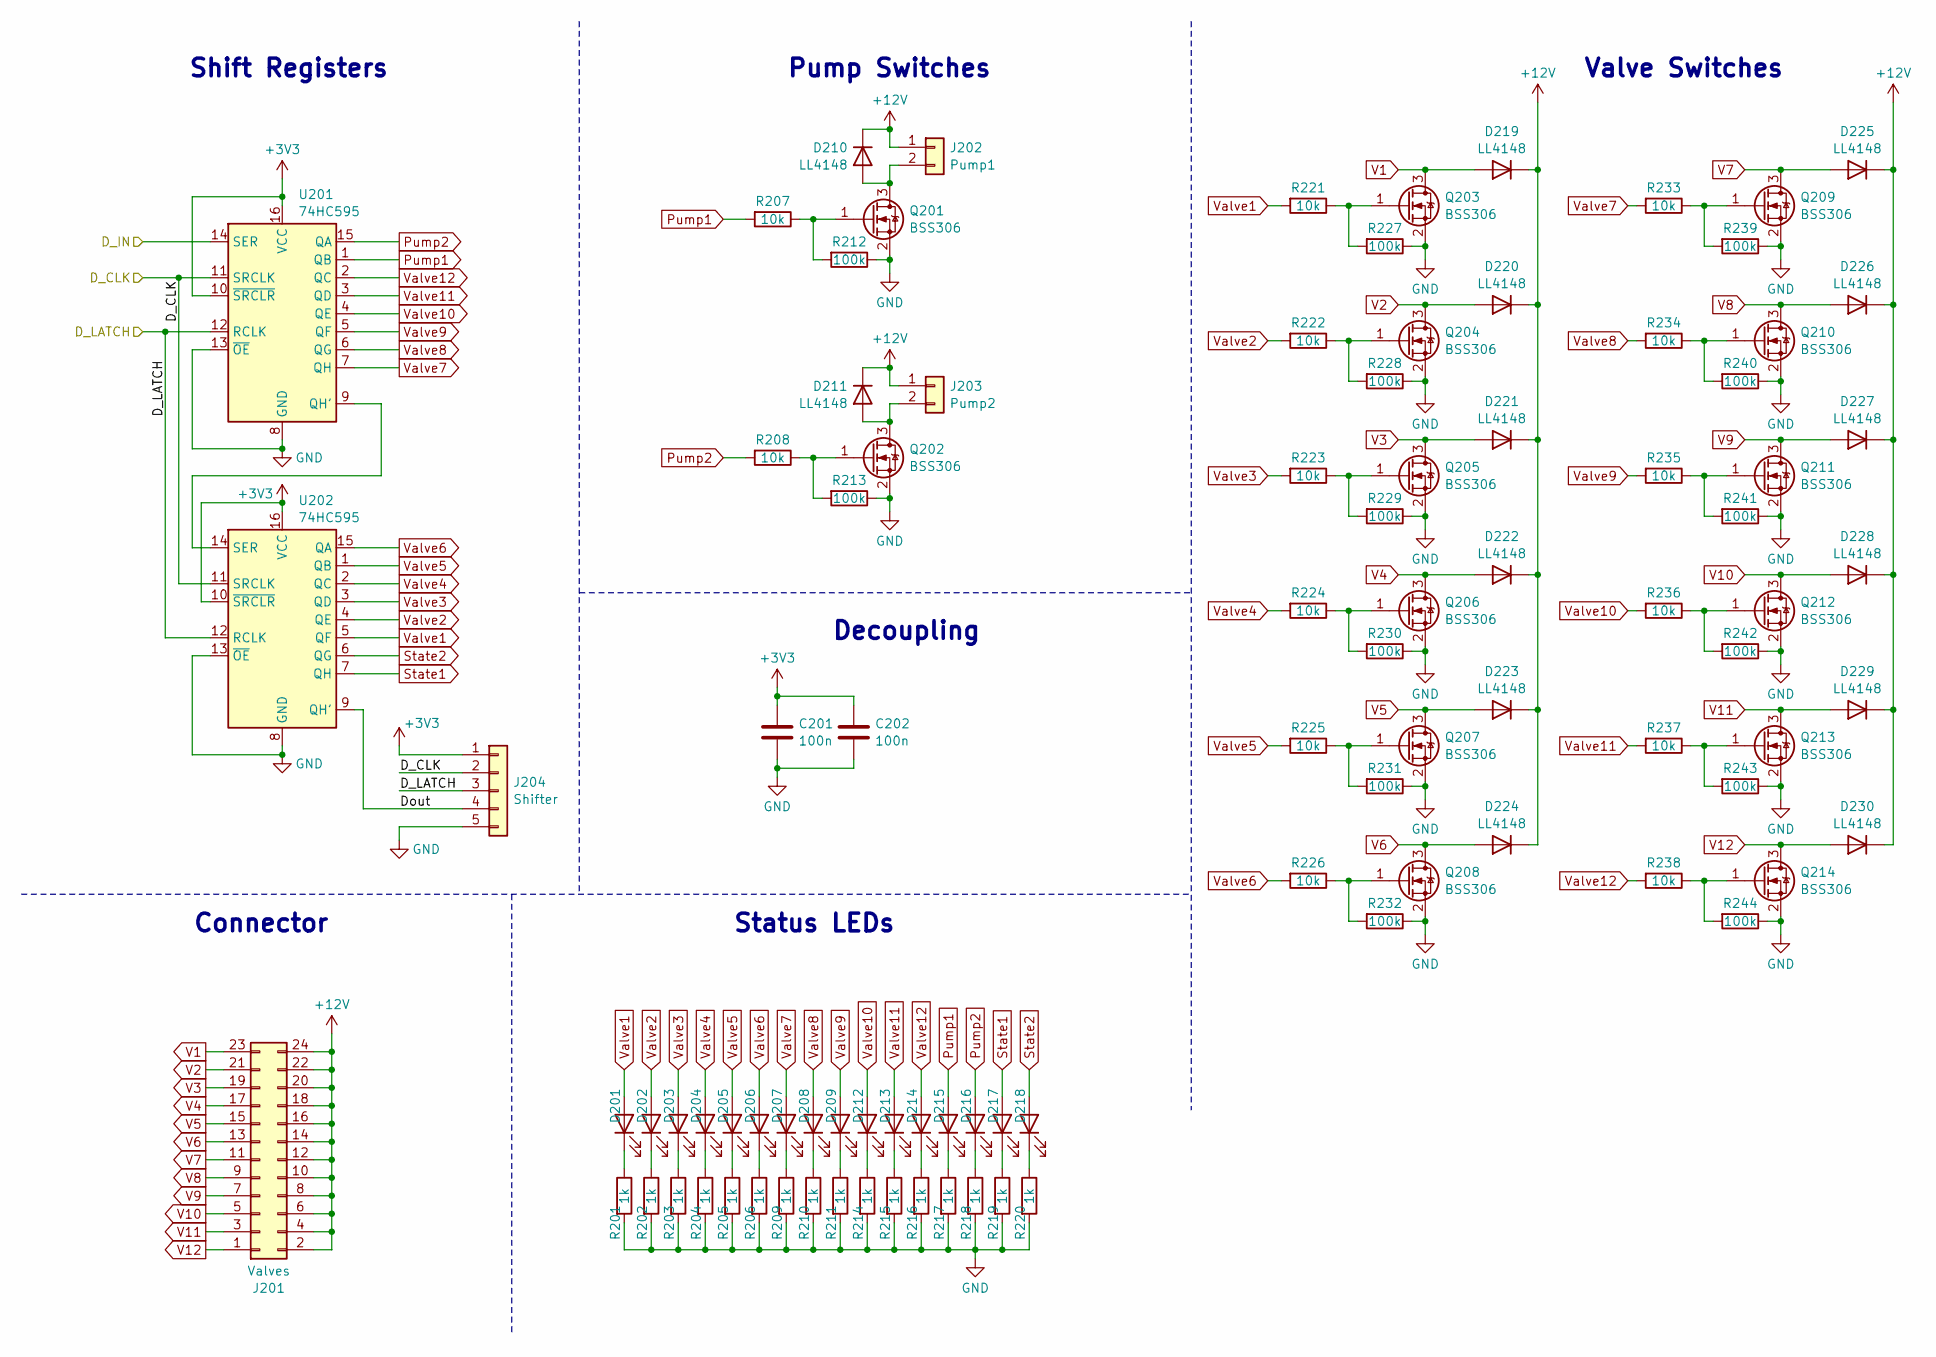
[picture p22: schematic Actors.kicad_sch]

Parts:
C201, C202: 100n; C_0805_2012Metric
D201, D202, D203, D204, D205, D206, D207, D208, D209, D212, D213, D214, D215, D216, D217, D218: LED; LED_0805_2012Metric
D210, D211, D219, D220, D221, D222, D223, D224, D225, D226, D227, D228, D229, D230: LL4148; D_MiniMELF
J201: Valves; PinHeader_2x12_P2.54mm_Vertical
J202: Pump1; JST_XH_B2B-XH-A_1x02_P2.50mm_Vertical
J203: Pump2; JST_XH_B2B-XH-A_1x02_P2.50mm_Vertical
J204: Shifter; PinSocket_1x05_P2.54mm_Vertical
Q201, Q202, Q203, Q204, Q205, Q206, Q207, Q208, Q209, Q210, Q211, Q212, Q213, Q214: BSS306; SOT-23-3
R201, R202, R203, R204, R205, R206, R209, R210, R211, R214, R215, R216, R217, R218, R219, R220: 1k; R_0805_2012Metric
R207, R208, R221, R222, R223, R224, R225, R226, R233, R234, R235, R236, R237, R238: 10k; R_0805_2012Metric
R212, R213, R227, R228, R229, R230, R231, R232, R239, R240, R241, R242, R243, R244: 100k; R_0805_2012Metric
U201, U202: 74HC595; SOIC-16_4.55x10.3mm_P1.27mm

Connections:
+3V3: C201.1, C202.1, J204.1, U201.10 (~SRCLR), U201.16 (VCC), U202.10 (~SRCLR), U202.16 (VCC); also elsewhere on the board
+12V: D210.1 (K), D211.1 (K), D219.1 (K), D220.1 (K), D221.1 (K), D222.1 (K), D223.1 (K), D224.1 (K), D225.1 (K), D226.1 (K), D227.1 (K), D228.1 (K), D229.1 (K), D230.1 (K), J201.2, J201.4, J201.6, J201.8, J201.10, J201.12, J201.14, J201.16, J201.18, J201.20, J201.22, J201.24, J202.1, J203.1; also elsewhere on the board
/Valves and Pumps/Dout: J204.4, U202.9 (QH')
DCLK: J204.2, U201.11 (SRCLK), U202.11 (SRCLK); also elsewhere on the board
DLATCH: J204.3, U201.12 (RCLK), U202.12 (RCLK); also elsewhere on the board
DOUT: U201.14 (SER); also elsewhere on the board
GND: C201.2, C202.2, J204.5, Q201.2 (S), Q202.2 (S), Q203.2 (S), Q204.2 (S), Q205.2 (S), Q206.2 (S), Q207.2 (S), Q208.2 (S), Q209.2 (S), Q210.2 (S), Q211.2 (S), Q212.2 (S), Q213.2 (S), Q214.2 (S), R201.2, R202.2, R203.2, R204.2, R205.2, R206.2, R209.2, R210.2, R211.2, R212.1, R213.1, R214.2, R215.2, R216.2, R217.2, R218.2, R219.2, R220.2, R227.1, R228.1, R229.1, R230.1, R231.1, R232.1, R239.1, R240.1, R241.1, R242.1, R243.1, R244.1, U201.8 (GND), U201.13 (~OE), U202.8 (GND), U202.13 (~OE); also elsewhere on the board
unnamed: D201.1 (K), R201.1
unnamed: D202.1 (K), R202.1
unnamed: D203.1 (K), R203.1
unnamed: D204.1 (K), R204.1
unnamed: D205.1 (K), R205.1
unnamed: D206.1 (K), R206.1
unnamed: D207.1 (K), R209.1
unnamed: D208.1 (K), R210.1
unnamed: D209.1 (K), R211.1
unnamed: D210.2 (A), J202.2, Q201.3 (D)
unnamed: D211.2 (A), J203.2, Q202.3 (D)
unnamed: D212.1 (K), R214.1
unnamed: D213.1 (K), R215.1
unnamed: D214.1 (K), R216.1
unnamed: D215.1 (K), R217.1
unnamed: D216.1 (K), R218.1
unnamed: D217.1 (K), R219.1
unnamed: D218.1 (K), R220.1
unnamed: Q201.1 (G), R207.1, R212.2
unnamed: Q202.1 (G), R208.1, R213.2
unnamed: Q203.1 (G), R221.1, R227.2
unnamed: Q204.1 (G), R222.1, R228.2
unnamed: Q205.1 (G), R223.1, R229.2
unnamed: Q206.1 (G), R224.1, R230.2
unnamed: Q207.1 (G), R225.1, R231.2
unnamed: Q208.1 (G), R226.1, R232.2
unnamed: Q209.1 (G), R233.1, R239.2
unnamed: Q210.1 (G), R234.1, R240.2
unnamed: Q211.1 (G), R235.1, R241.2
unnamed: Q212.1 (G), R236.1, R242.2
unnamed: Q213.1 (G), R237.1, R243.2
unnamed: Q214.1 (G), R238.1, R244.2
unnamed: U201.9 (QH'), U202.14 (SER)
Pump1: D215.2 (A), R207.2, U201.1 (QB)
Pump2: D216.2 (A), R208.2, U201.15 (QA)
State1: D217.2 (A), U202.7 (QH)
State2: D218.2 (A), U202.6 (QG)
V1: D219.2 (A), J201.23, Q203.3 (D)
V2: D220.2 (A), J201.21, Q204.3 (D)
V3: D221.2 (A), J201.19, Q205.3 (D)
V4: D222.2 (A), J201.17, Q206.3 (D)
V5: D223.2 (A), J201.15, Q207.3 (D)
V6: D224.2 (A), J201.13, Q208.3 (D)
V7: D225.2 (A), J201.11, Q209.3 (D)
V8: D226.2 (A), J201.9, Q210.3 (D)
V9: D227.2 (A), J201.7, Q211.3 (D)
V10: D228.2 (A), J201.5, Q212.3 (D)
V11: D229.2 (A), J201.3, Q213.3 (D)
V12: D230.2 (A), J201.1, Q214.3 (D)
Valve1: D201.2 (A), R221.2, U202.5 (QF)
Valve2: D202.2 (A), R222.2, U202.4 (QE)
Valve3: D203.2 (A), R223.2, U202.3 (QD)
Valve4: D204.2 (A), R224.2, U202.2 (QC)
Valve5: D205.2 (A), R225.2, U202.1 (QB)
Valve6: D206.2 (A), R226.2, U202.15 (QA)
Valve7: D207.2 (A), R233.2, U201.7 (QH)
Valve8: D208.2 (A), R234.2, U201.6 (QG)
Valve9: D209.2 (A), R235.2, U201.5 (QF)
Valve10: D212.2 (A), R236.2, U201.4 (QE)
Valve11: D213.2 (A), R237.2, U201.3 (QD)
Valve12: D214.2 (A), R238.2, U201.2 (QC)

Notes on the sheet:
Valve Switches
Connector
Pump Switches
Status LEDs
Shift Registers
Decoupling

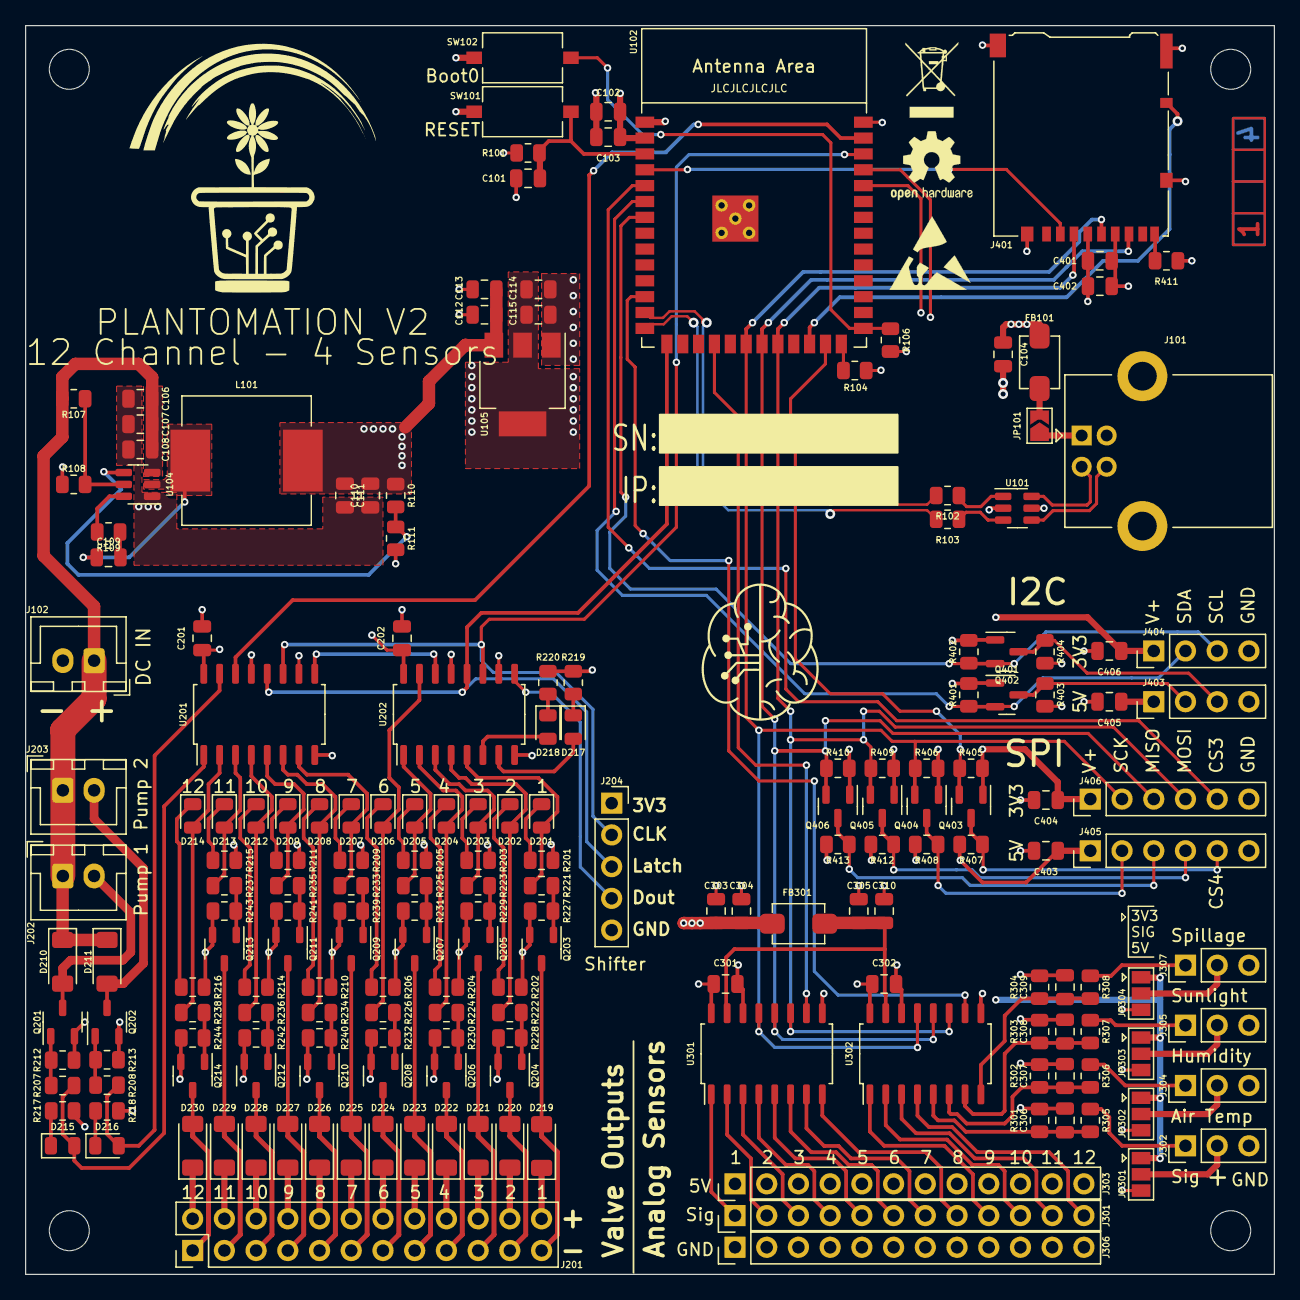
[picture p23: board Plantomation_V2.kicad_pcb from above]

Board: 4 copper layers, 100.0 x 100.0 mm, 198 parts (0 on the bottom side), 128 nets.

Other parts of the board:
C112, C115: 4µ7; C_0805_2012Metric
C113, C114, C402: 100n; C_0805_2012Metric
C401: 1µ; C_0805_2012Metric
R301, R302, R303, R304: R; R_0805_2012Metric
R305, R306, R307, R308: 100; R_0805_2012Metric
R411: 1k; R_0805_2012Metric
Ref**: Val**; ladder_4
U105: AMS1117-3.3; SOT-223-3_TabPin2

Their connections:
+3V3: C114.1, C115.1, C401.1, C402.1, R411.1, U105.2 (VO); also elsewhere on the board
+5V: C112.1, C113.1, U105.3 (VI); also elsewhere on the board
GND: C112.2, C113.2, C114.2, C115.2, C401.2, C402.2, R301.1, R302.1, R303.1, R304.1, U105.1 (GND); also elsewhere on the board
unnamed 43: R305.1; also elsewhere on the board
unnamed 45: R306.1; also elsewhere on the board
unnamed 47: R307.1; also elsewhere on the board
unnamed 49: R308.1; also elsewhere on the board
unnamed 51: R411.2; also elsewhere on the board
unnamed 75: R301.2, R305.2; also elsewhere on the board
unnamed 76: R302.2, R306.2; also elsewhere on the board
unnamed 77: R303.2, R307.2; also elsewhere on the board
unnamed 78: R304.2, R308.2; also elsewhere on the board
