Synthron/Plantomation/V1/Hardware/Plantomation.kicad_pcb

## KiCad design V1/Hardware/Plantomation.kicad_pcb (2023-11-30, an earlier design)

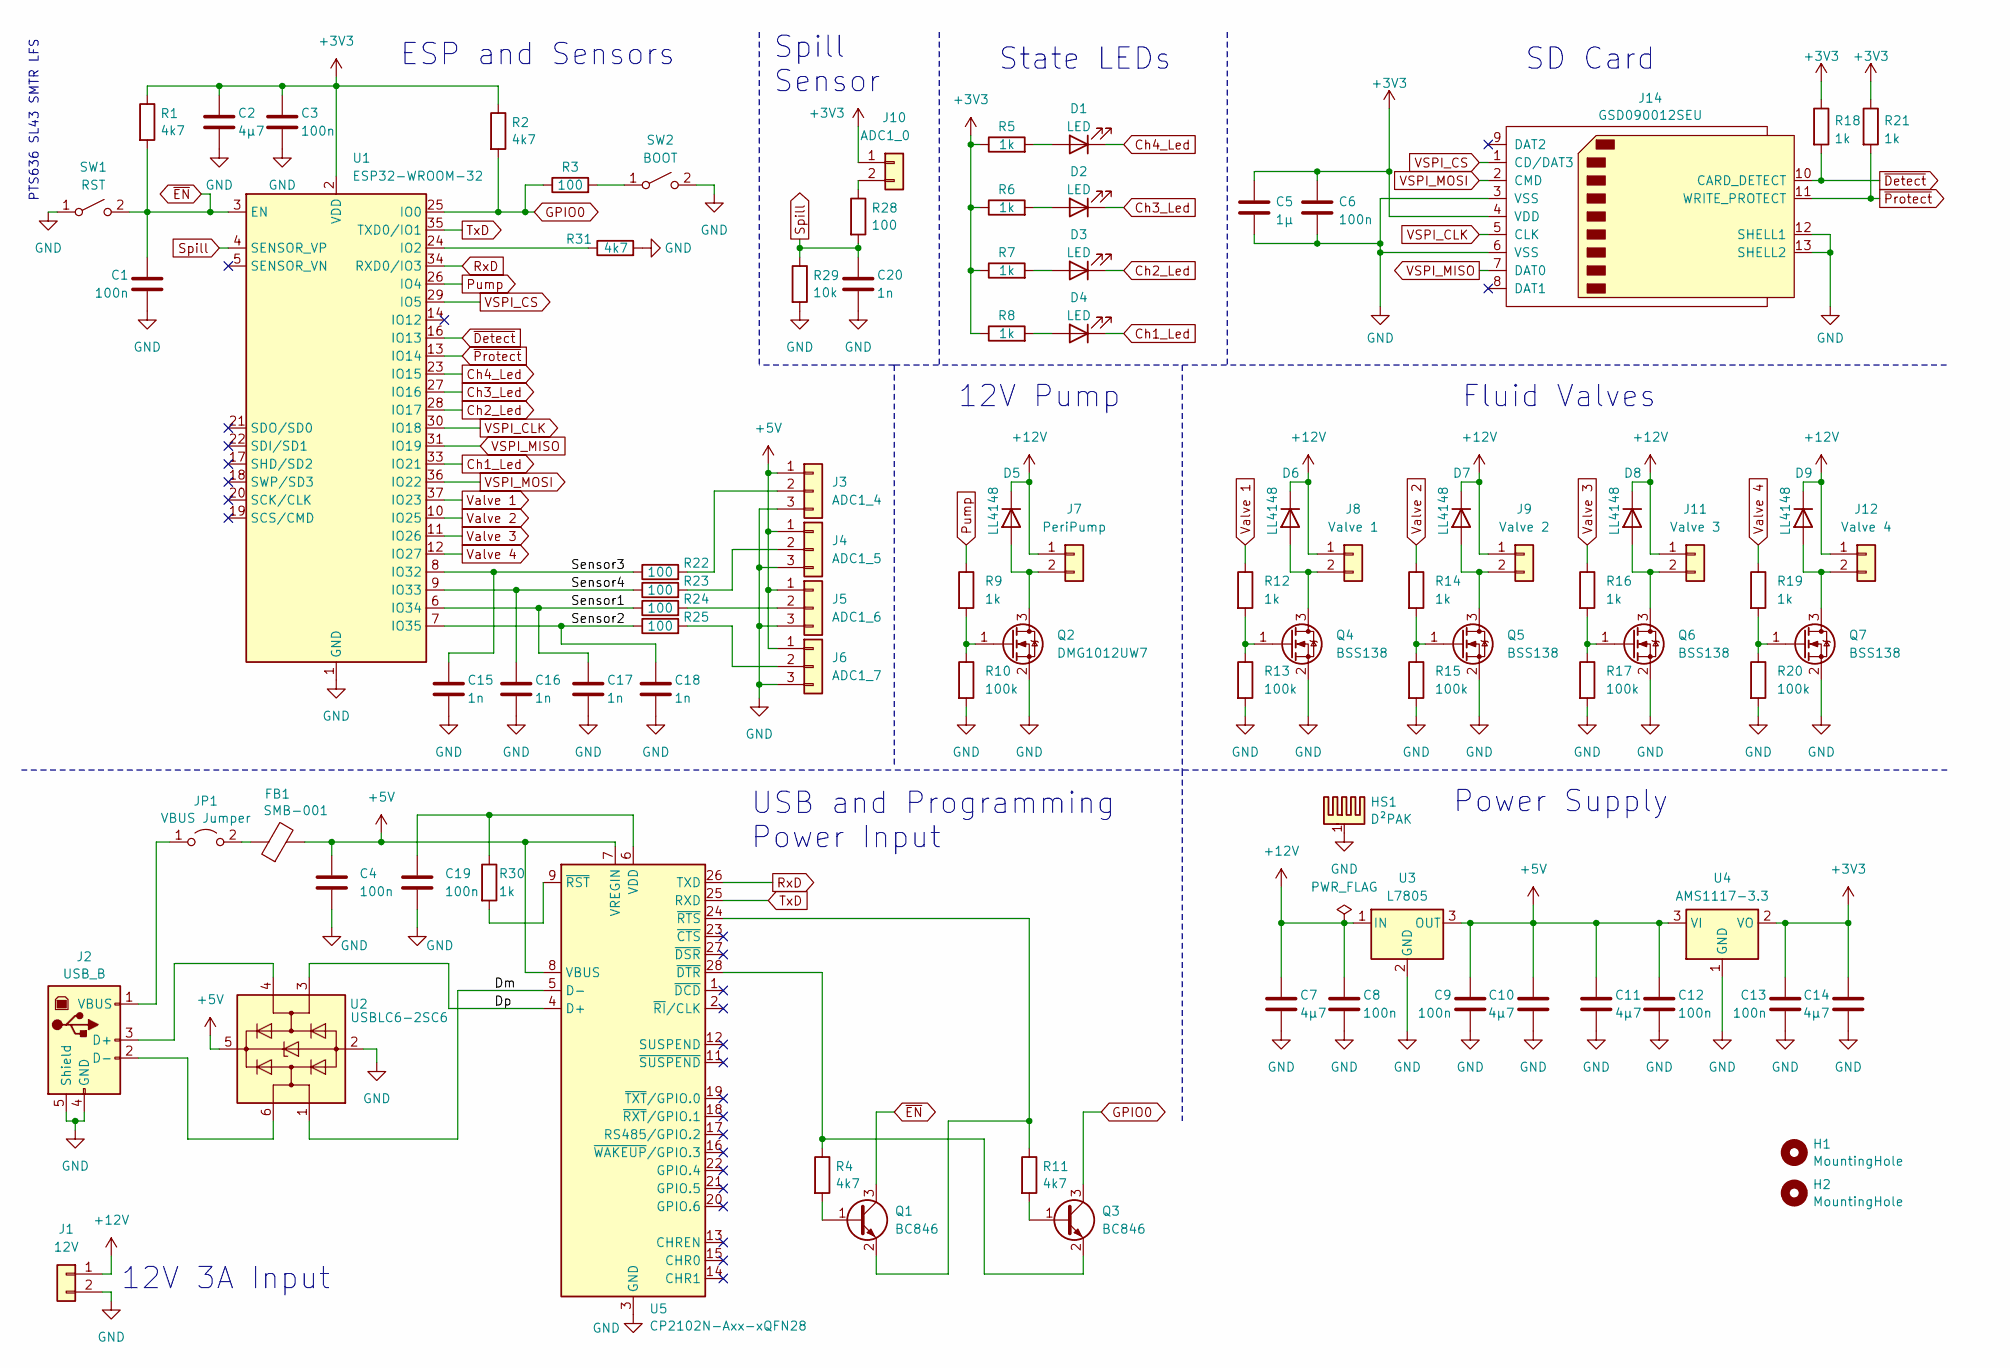
[picture p24: schematic Plantomation.kicad_sch]

Parts:
C1, C3, C4, C6, C8, C9, C12, C13, C19: 100n; C_0805_2012Metric
C2, C7, C10, C11, C14: 4µ7; C_0805_2012Metric
C5: 1µ; C_0805_2012Metric
C15, C16, C17, C18, C20: 1n; C_0805_2012Metric
D1, D2, D3, D4: LED; LED_0805_2012Metric
D5, D6, D7, D8, D9: LL4148; D_MiniMELF
FB1: SMB-001; SMB-002
H1, H2: MountingHole; MountingHole_3.2mm_M3
HS1: D²PAK; Heatsink_Fischer_FK24413DPAK_23x13mm
J1: 12V; JST_XH_B2B-XH-A_1x02_P2.50mm_Vertical
J2: USB_B; USB_B_Lumberg_2411_02_Horizontal
J3: ADC1_4; JST_XH_B3B-XH-A_1x03_P2.50mm_Vertical
J4: ADC1_5; JST_XH_B3B-XH-A_1x03_P2.50mm_Vertical
J5: ADC1_6; JST_XH_B3B-XH-A_1x03_P2.50mm_Vertical
J6: ADC1_7; JST_XH_B3B-XH-A_1x03_P2.50mm_Vertical
J7: PeriPump; JST_XH_B2B-XH-A_1x02_P2.50mm_Vertical
J8: Valve 1; JST_XH_B2B-XH-A_1x02_P2.50mm_Vertical
J9: Valve 2; JST_XH_B2B-XH-A_1x02_P2.50mm_Vertical
J10: ADC1_0; JST_XH_B2B-XH-A_1x02_P2.50mm_Vertical
J11: Valve 3; JST_XH_B2B-XH-A_1x02_P2.50mm_Vertical
J12: Valve 4; JST_XH_B2B-XH-A_1x02_P2.50mm_Vertical
J14: GSD090012SEU
JP1: VBUS Jumper; PinHeader_1x02_P2.54mm_Vertical
Q1, Q3: BC846; SOT-23
Q2: DMG1012UW7; SOT-23
Q4, Q5, Q6, Q7: BSS138; SOT-23
R1, R2, R4, R11, R31: 4k7; R_0805_2012Metric
R3, R22, R23, R24, R25, R28: 100; R_0805_2012Metric
R5, R6, R7, R8, R9, R12, R14, R16, R18, R19, R21, R30: 1k; R_0805_2012Metric
R10, R13, R15, R17, R20: 100k; R_0805_2012Metric
R29: 10k; R_0805_2012Metric
SW1: RST; SW_Tactile_SPST_NO_Straight_CK_PTS636Sx25SMTRLFS
SW2: BOOT; SW_Tactile_SPST_NO_Straight_CK_PTS636Sx25SMTRLFS
U1: ESP32-WROOM-32
U2: USBLC6-2SC6; SOT-23-6
U3: L7805; TO-252-2
U4: AMS1117-3.3; SOT-223-3_TabPin2
U5: CP2102N-Axx-xQFN28; QFN-28-1EP_5x5mm_P0.5mm_EP3.35x3.35mm

Connections:
+3V3: C2.1, C3.1, C5.1, C6.1, C13.1, C14.1, J10.1, J14.4 (VDD), R1.1, R2.1, R5.1, R6.1, R7.1, R8.1, R18.1, R21.1, U1.2 (VDD), U4.2 (VO)
+5V: C4.1, C9.1, C10.1, C11.1, C12.1, FB1.2, J3.1, J4.1, J5.1, J6.1, U2.5 (VBUS), U3.3 (OUT), U4.3 (VI), U5.7 (VREGIN), U5.8 (VBUS)
+12V: C7.1, C8.1, D5.1 (K), D6.1 (K), D7.1 (K), D8.1 (K), D9.1 (K), J1.1, J7.1, J8.1, J9.1, J11.1, J12.1, U3.1 (IN)
/Dm: U2.1 (I/O1), U5.5 (D-)
/Dp: U2.3 (I/O2), U5.4 (D+)
/Sensor1: C17.1, R24.1, U1.6 (IO34)
/Sensor2: C18.1, R25.1, U1.7 (IO35)
/Sensor3: C15.1, R22.1, U1.8 (IO32)
/Sensor4: C16.1, R23.1, U1.9 (IO33)
Ch1_Led: D4.1 (K), U1.33 (IO21)
Ch2_Led: D3.1 (K), U1.28 (IO17)
Ch3_Led: D2.1 (K), U1.27 (IO16)
Ch4_Led: D1.1 (K), U1.23 (IO15)
GND: C1.2, C2.2, C3.2, C4.2, C5.2, C6.2, C7.2, C8.2, C9.2, C10.2, C11.2, C12.2, C13.2, C14.2, C15.2, C16.2, C17.2, C18.2, C19.2, C20.2, HS1.1, J1.2, J2.4 (GND), J2.5 (Shield), J3.3, J4.3, J5.3, J6.3, J14.3 (VSS), J14.6 (VSS), J14.12 (SHELL1), J14.13 (SHELL2), Q2.2 (S), Q4.2 (S), Q5.2 (S), Q6.2 (S), Q7.2 (S), R10.2, R13.2, R15.2, R17.2, R20.2, R29.2, R31.2, SW1.1 (A), SW2.2 (B), U1.1 (GND), U1.15 (GND), U1.38 (GND), U1.39 (GND), U2.2 (GND), U3.2 (GND), U4.1 (GND), U5.3 (GND), U5.29 (GND)
GPIO0: Q3.3 (C), R2.2, R3.1, U1.25 (IO0)
unnamed: D1.2 (A), R5.2
unnamed: D2.2 (A), R6.2
unnamed: D3.2 (A), R7.2
unnamed: D4.2 (A), R8.2
unnamed: D5.2 (A), J7.2, Q2.3 (D)
unnamed: D6.2 (A), J8.2, Q4.3 (D)
unnamed: D7.2 (A), J9.2, Q5.3 (D)
unnamed: D8.2 (A), J11.2, Q6.3 (D)
unnamed: D9.2 (A), J12.2, Q7.3 (D)
unnamed: J2.3 (D+), U2.4 (I/O2)
unnamed: J2.2 (D-), U2.6 (I/O1)
unnamed: J2.1 (VBUS), JP1.1 (A)
unnamed: J3.2, R22.2
unnamed: J4.2, R23.2
unnamed: J5.2, R24.2
unnamed: J6.2, R25.2
unnamed: J10.2, R28.1
unnamed: FB1.1, JP1.2 (B)
unnamed: Q1.1 (B), R4.2
unnamed: Q1.2 (E), R11.1, U5.24 (~RTS)
unnamed: Q2.1 (G), R9.2, R10.1
unnamed: Q3.1 (B), R11.2
unnamed: Q3.2 (E), R4.1, U5.28 (~DTR)
unnamed: Q4.1 (G), R12.2, R13.1
unnamed: Q5.1 (G), R14.2, R15.1
unnamed: Q6.1 (G), R16.2, R17.1
unnamed: Q7.1 (G), R19.2, R20.1
unnamed: R3.2, SW2.1 (A)
unnamed: R31.1, U1.24 (IO2)
unnamed: C19.1, R30.1, U5.6 (VDD)
unnamed: R30.2, U5.9 (~RST)
Pump: R9.1, U1.26 (IO4)
RxD: U1.34 (RXD0/IO3), U5.26 (TXD)
Spill: C20.1, R28.2, R29.1, U1.4 (SENSOR_VP)
TxD: U1.35 (TXD0/IO1), U5.25 (RXD)
VSPI_CLK: J14.5 (CLK), U1.30 (IO18)
VSPI_CS: J14.1 (CD/DAT3), U1.29 (IO5)
VSPI_MISO: J14.7 (DAT0), U1.31 (IO19)
VSPI_MOSI: J14.2 (CMD), U1.36 (IO22)
Valve 1: R12.1, U1.37 (IO23)
Valve 2: R14.1, U1.10 (IO25)
Valve 3: R16.1, U1.11 (IO26)
Valve 4: R19.1, U1.12 (IO27)
~Detect: J14.10 (CARD_DETECT), R18.2, U1.16 (IO13)
~EN: C1.1, Q1.3 (C), R1.2, SW1.2 (B), U1.3 (EN)
~Protect: J14.11 (WRITE_PROTECT), R21.2, U1.13 (IO14)

Notes on the sheet:
State LEDs
12V 3A Input
Fluid Valves
ESP and Sensors
12V Pump
SD Card
Power Supply
USB and Programming Power Input
Spill Sensor
PTS636 SL43 SMTR LFS

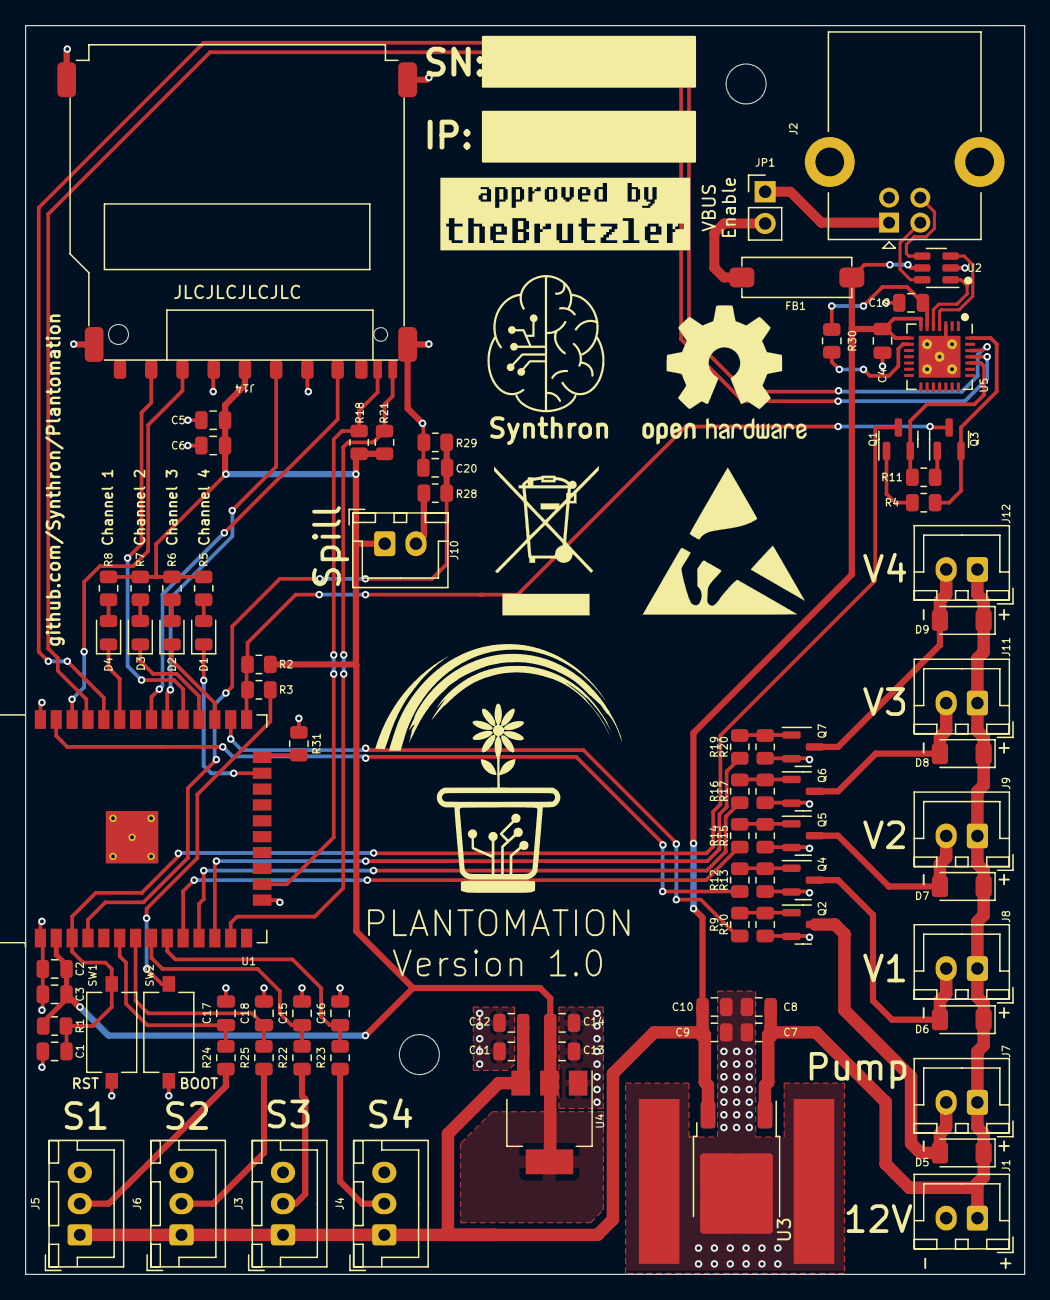
[picture p25: board Plantomation.kicad_pcb from above]

Board: 2 copper layers, 80.0 x 100.0 mm, 90 parts (0 on the bottom side), 61 nets.
