Synthron/Plantomation/V2/Firmware/src/config.h

#pragma one

#define DOUT    1
#define DCLK    2
#define DLATCH  3
#define CS2     4
#define CS3     5
#define SDA     6
#define SCL     7
#define CS1     8
#define CS0     10
#define SCK     12
#define MISO    13
#define MOSI    14
#define TxD1    17
#define RxD1    18
#define DIR     38
#define DETECT  47
#define CS4     48
