Synthron/Plantomation/(commit log)

2023-11-26 Layout finalization
    [Plantomation.kicad_pcb, Plantomation.kicad_sch, SD Card.STEP, carrier_plate.FCStd]
2023-11-27 Finishing Touches on Layout before Review
    [GSD090012SEU.stp, Plantomation.kicad_pcb, Plantomation.kicad_sch, SD Card.STEP, USB-B-S-F-B-TH.stp, fk_244_13_d_pak.stp]
2023-11-28 codebase and first part review
    [Plantomation.kicad_sch]
2023-11-29 Big Repo Overhaul Started Documentation First Review Overhaul of Schematic and Layout First working Test Code for webpage and OTA
    [Plantomation.kicad_pcb, Plantomation.kicad_sch]
2023-11-30 Finalizing PCB and Review Firmware Bugfixes for Ajax Firmware get a working responsive page layout
    [Plantomation.kicad_pcb, Plantomation.kicad_sch, base.3mf, carrier_plate.FCStd, fixer.3mf, hose_fix.3mf]
2023-12-03 Config Update 1 update doc for configuration files still needs new update for json instead of xml update code to use AP mode when no config or wifi
    [base.3mf, carrier_plate.FCStd]
2023-12-04 add schematic PDF
2023-12-06 attempted fix: extern for global instances, didn't work
    [classes.h, main.h, server.h]
2024-01-11 Major Code Update implement SD implement sensors expand config page implement file system on SD implement debug level implement log level
2024-01-11 Bugfix for gefault SSID
    [server.cpp]
2024-01-11 bugfix boot message order
    [main.cpp]
2024-03-05 Add V2, Cleanup Repo
    [Actors.kicad_sch, DM3AT-SF-PEJM5--3DModel-STEP-1.STEP, GSD090012SEU.stp, IHLP4040DZ (2.2-100uH).STEP, Interface.kicad_sch, Plantomation.kicad_pcb, Plantomation.kicad_sch, Plantomation_V2.csv]
2024-03-17 prepare code and 3d files
    [Plantomation_V2.kicad_pcb, baseplate-fixbar.3mf, baseplate.3mf, baseplate.FCStd]
2024-04-07 V1: Critical Code Fix preventing correct working
    [Valve_Bar.3mf, base.3mf, base_v2.FCStd]
2024-06-03 Start Code for V2
    [Actors.kicad_sch, Interface.kicad_sch, Plantomation_V2.kicad_sch, Sensors.kicad_sch]
