Synthron/Plantomation/(notices)

Notices in the files:
V1/Hardware/3d_models/USB-B-S-F-B-TH.stp:
author */ ('License CC BY-ND 4.0'),
